LeoMaden/IDP-Robot-CAD/Robot-final-assembly.SLDASM

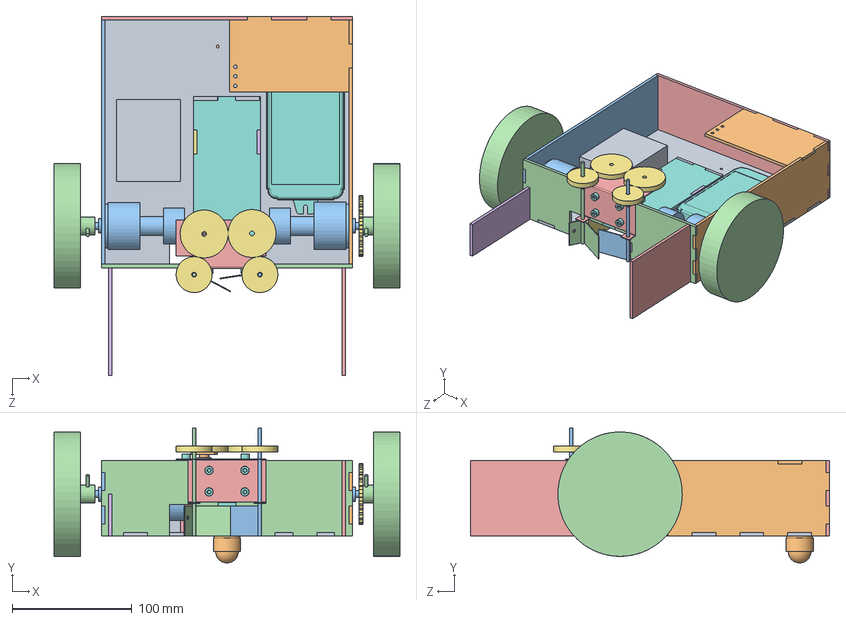
[picture p1: CAD file, 2020-11-09]
Robot-final-assembly.SLDASM
289.0 x 112.6 x 300.0 mm
Body-bottom
Body-left
Body-right
Body-front
Body-rear
Tunnel-left
Tunnel-right
Tunnel-top
Tunnel-rear
Name-plaque
Door-left
Door-right
Door-bracket
Servo
Gears x 4
socket head cap screw_iso x 8
hex thin nut chamfered gradeab_iso x 7
Servo-spline-piece
Large-motor x 2
Wheel x 2
Tall-ultrasound-piece
Short-ultrasound-piece
Toothed-wheel
Battery-box
Arduino-motor-shield
Caster Ball
