LeoMaden/IDP-Robot-CAD/Door-assembly.SLDASM

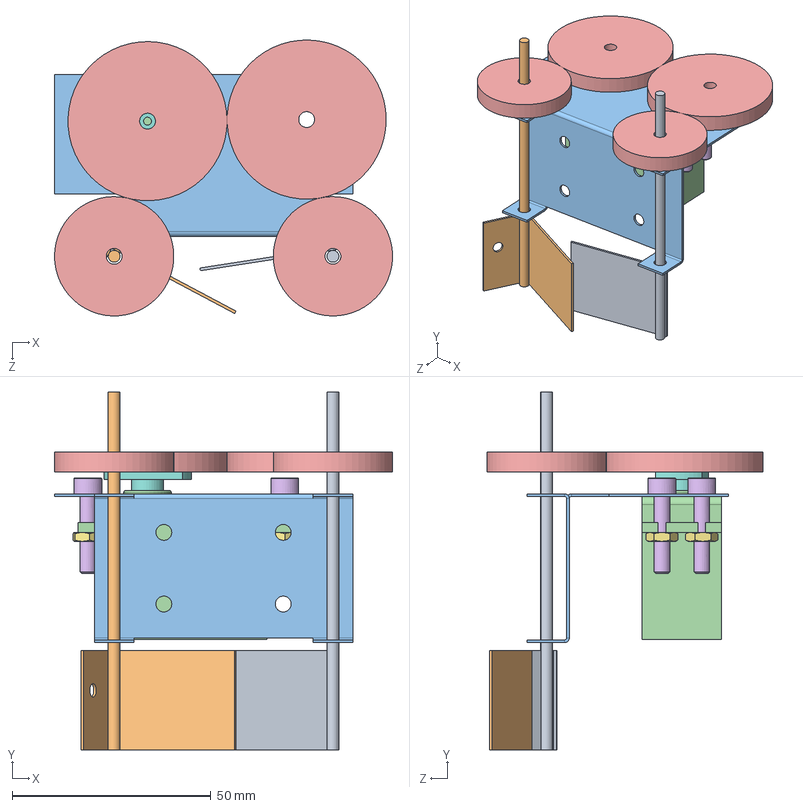
[picture p2: CAD file, 2020-11-09]
Door-assembly.SLDASM
85.0 x 90.0 x 69.4 mm
Door-left
Door-right
Door-bracket
Servo
Gears x 4
socket head cap screw_iso x 4
hex thin nut chamfered gradeab_iso x 3
Servo-spline-piece
