LeoMaden/IDP-Robot-CAD/Robot-assembly.SLDASM

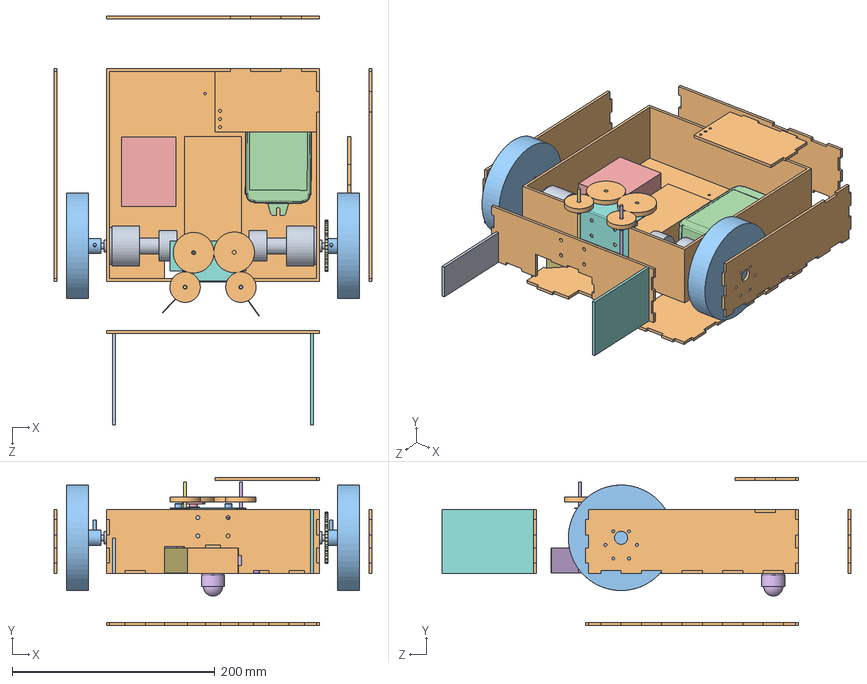
[picture p3: CAD file, 2020-11-08]
Robot-assembly.SLDASM
313.0 x 146.0 x 403.0 mm
Large-motor x 2
Robot-body
Wheel x 2
Battery-box
Arduino-motor-shield
Door-left
Door-right
Door-bracket
Servo
Gears x 4
socket head cap screw_iso x 4
hex thin nut chamfered gradeab_iso x 3
Servo-spline-piece
Caster Ball
Toothed-wheel
Tall-ultrasound-piece
Short-ultrasound-piece
