LeoMaden/IDP-Robot-CAD/Documentation/dxf drawings/Robot DXF Files/Body-right.DXF

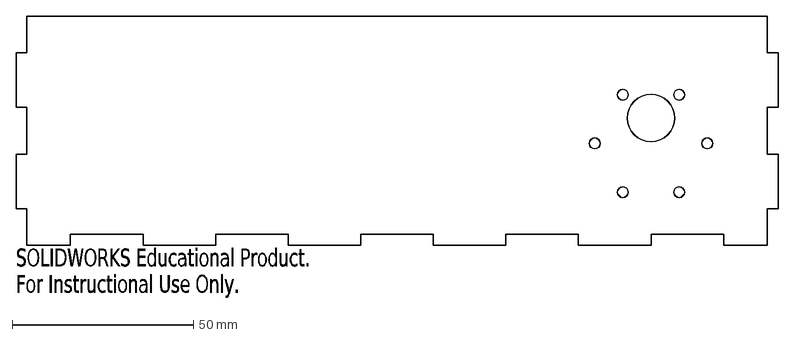
[picture p4: CAD file, 2020-11-09]
Documentation/dxf drawings/Robot DXF Files/Body-right.DXF
SOLIDWORKS Educational Product.
For Instructional Use Only.
