LeoMaden/IDP-Robot-CAD/Documentation/dxf drawings/Toothed-wheel.DXF

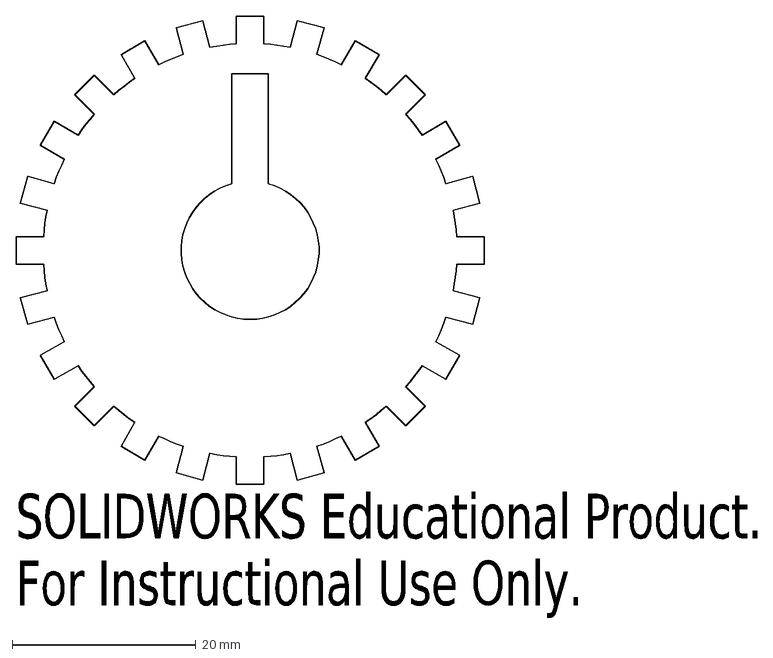
[picture p5: CAD file, 2020-11-09]
Documentation/dxf drawings/Toothed-wheel.DXF
SOLIDWORKS Educational Product.
For Instructional Use Only.
