LeoMaden/IDP-Robot-CAD/Name-plaque.sldprt

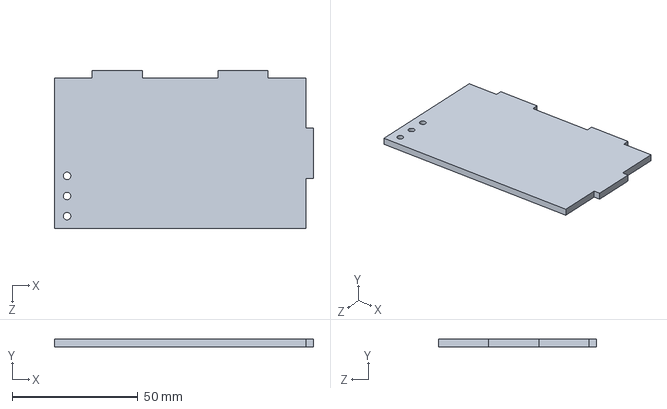
[picture p6: CAD file, 2020-11-09]
Name-plaque.sldprt
103.0 x 3.00 x 63.0 mm
