LeoMaden/IDP-Robot-CAD/Body-bottom.sldprt

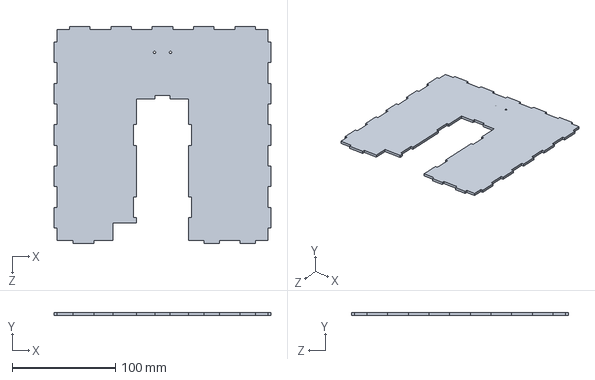
[picture p7: CAD file, 2020-11-09]
Body-bottom.sldprt
210.0 x 3.00 x 210.0 mm
