LeoMaden/IDP-Robot-CAD/Documentation/dxf drawings/Body-front.DXF

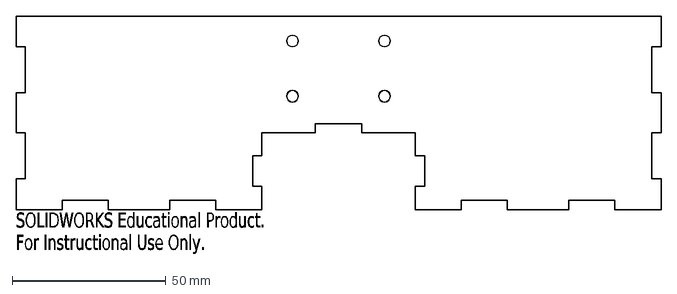
[picture p8: CAD file, 2020-11-09]
Documentation/dxf drawings/Body-front.DXF
SOLIDWORKS Educational Product.
For Instructional Use Only.
