LeoMaden/IDP-Robot-CAD/Documentation/dxf drawings/Robot DXF Files/New-Tunnel-right.DXF

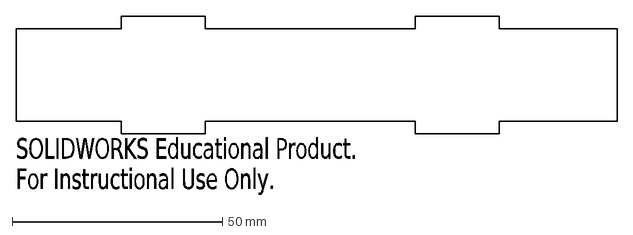
[picture p9: CAD file, 2020-11-09]
Documentation/dxf drawings/Robot DXF Files/New-Tunnel-right.DXF
SOLIDWORKS Educational Product.
For Instructional Use Only.
