LeoMaden/IDP-Robot-CAD/Documentation/dxf drawings/Body-bottom.DXF

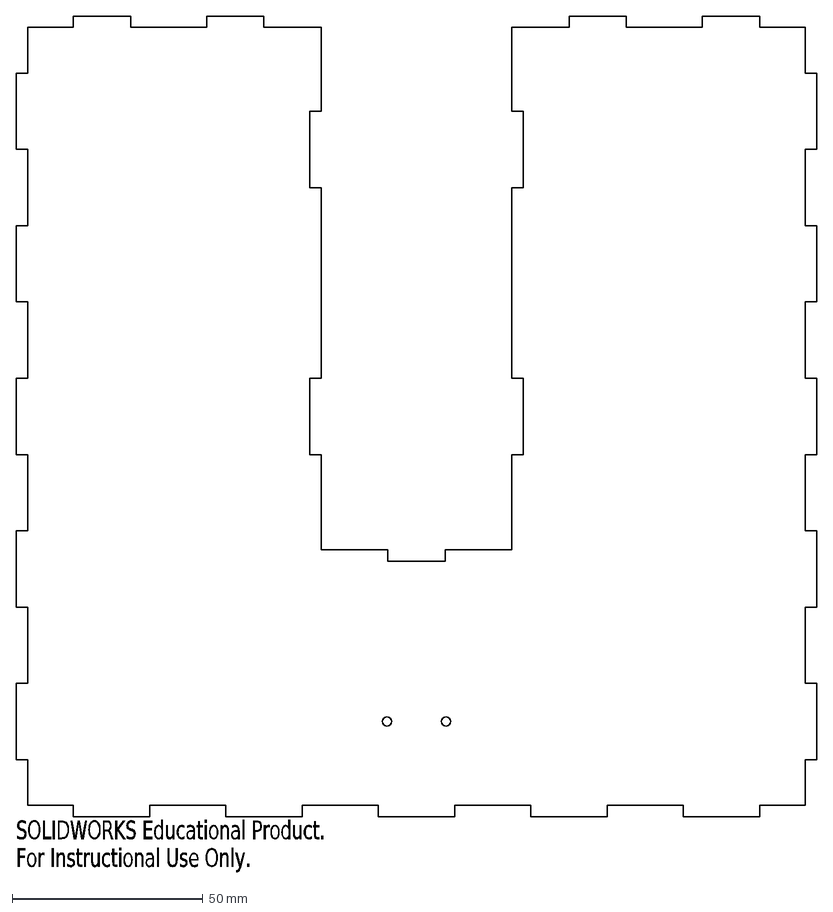
[picture p10: CAD file, 2020-11-09]
Documentation/dxf drawings/Body-bottom.DXF
SOLIDWORKS Educational Product.
For Instructional Use Only.
