LeoMaden/IDP-Robot-CAD/Documentation/dxf drawings/Robot DXF Files/Body-rear.DXF

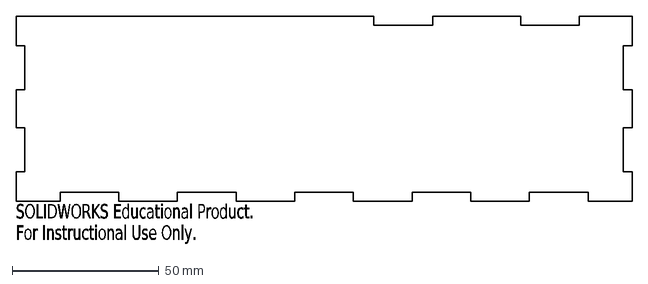
[picture p11: CAD file, 2020-11-09]
Documentation/dxf drawings/Robot DXF Files/Body-rear.DXF
SOLIDWORKS Educational Product.
For Instructional Use Only.
