LeoMaden/IDP-Robot-CAD/Tall-ultrasound-piece.SLDPRT

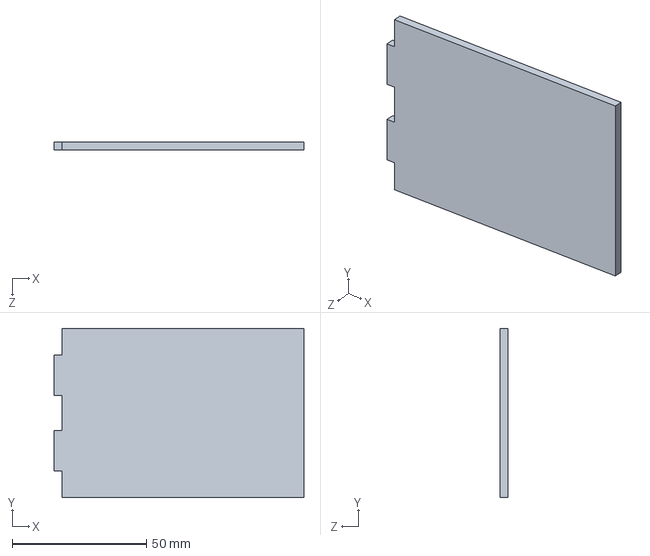
[picture p12: CAD file, 2020-11-09]
Tall-ultrasound-piece.SLDPRT
93.0 x 63.0 x 3.00 mm
