LeoMaden/IDP-Robot-CAD/Documentation/dxf drawings/Name-plaque.DXF

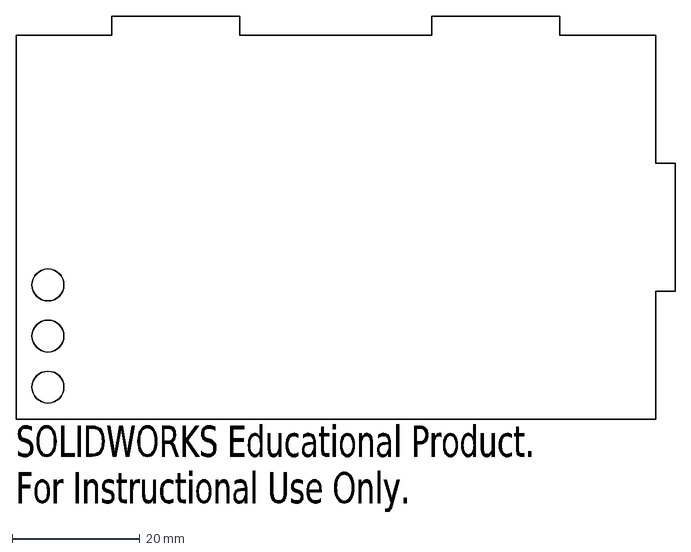
[picture p13: CAD file, 2020-11-09]
Documentation/dxf drawings/Name-plaque.DXF
SOLIDWORKS Educational Product.
For Instructional Use Only.
