LeoMaden/IDP-Robot-CAD/Documentation/dxf drawings/Robot DXF Files/New-Body-front.DXF

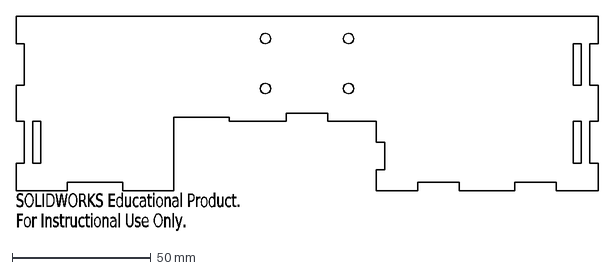
[picture p14: CAD file, 2020-11-09]
Documentation/dxf drawings/Robot DXF Files/New-Body-front.DXF
SOLIDWORKS Educational Product.
For Instructional Use Only.
