LeoMaden/IDP-Robot-CAD/Large-motor.SLDPRT

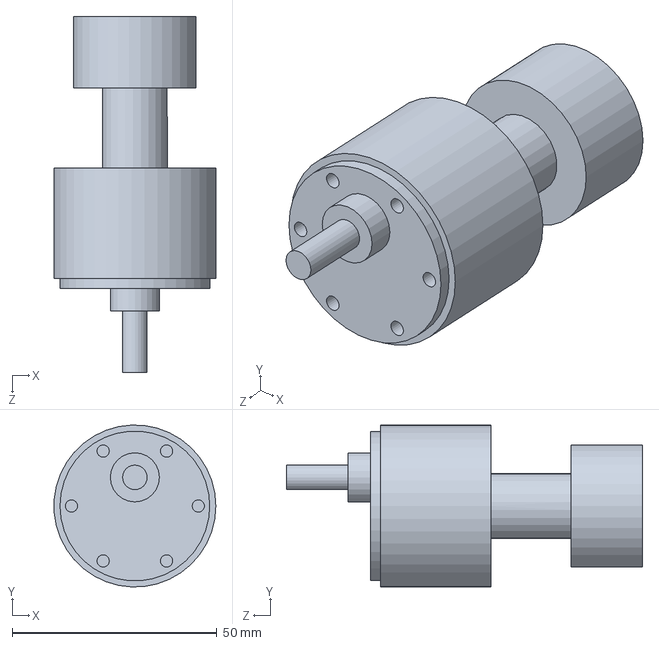
[picture p15: CAD file, 2020-11-09]
Large-motor.SLDPRT
39.5 x 39.6 x 87.0 mm
