LeoMaden/IDP-Robot-CAD/Documentation/dxf drawings/New-Body-bottom.DXF

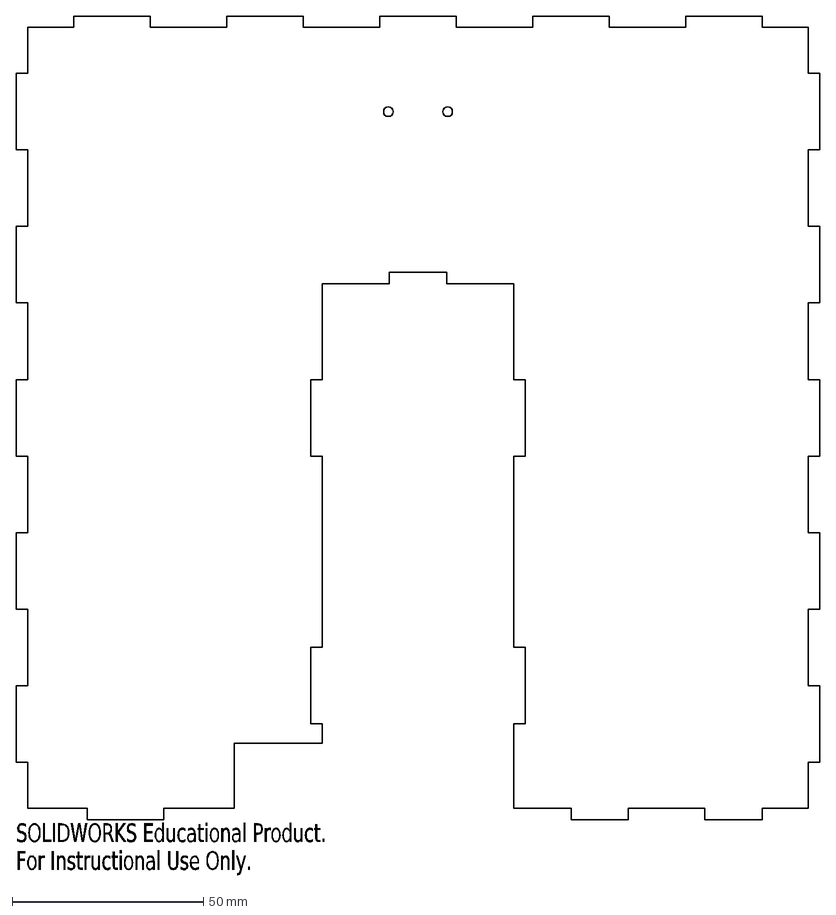
[picture p16: CAD file, 2020-11-03]
Documentation/dxf drawings/New-Body-bottom.DXF
SOLIDWORKS Educational Product.
For Instructional Use Only.
