LeoMaden/IDP-Robot-CAD/Documentation/dxf drawings/Robot DXF Files/Ultrasound-short.DXF

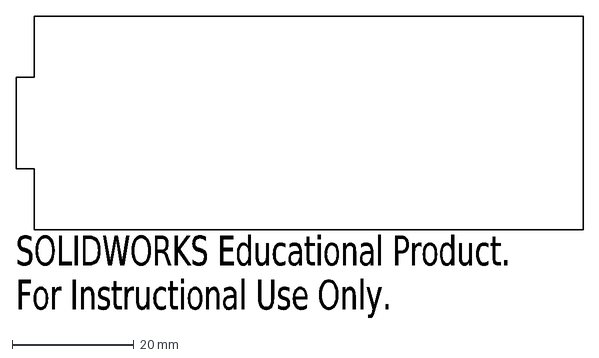
[picture p17: CAD file, 2020-11-09]
Documentation/dxf drawings/Robot DXF Files/Ultrasound-short.DXF
SOLIDWORKS Educational Product.
For Instructional Use Only.
