LeoMaden/IDP-Robot-CAD/Tunnel-left.sldprt

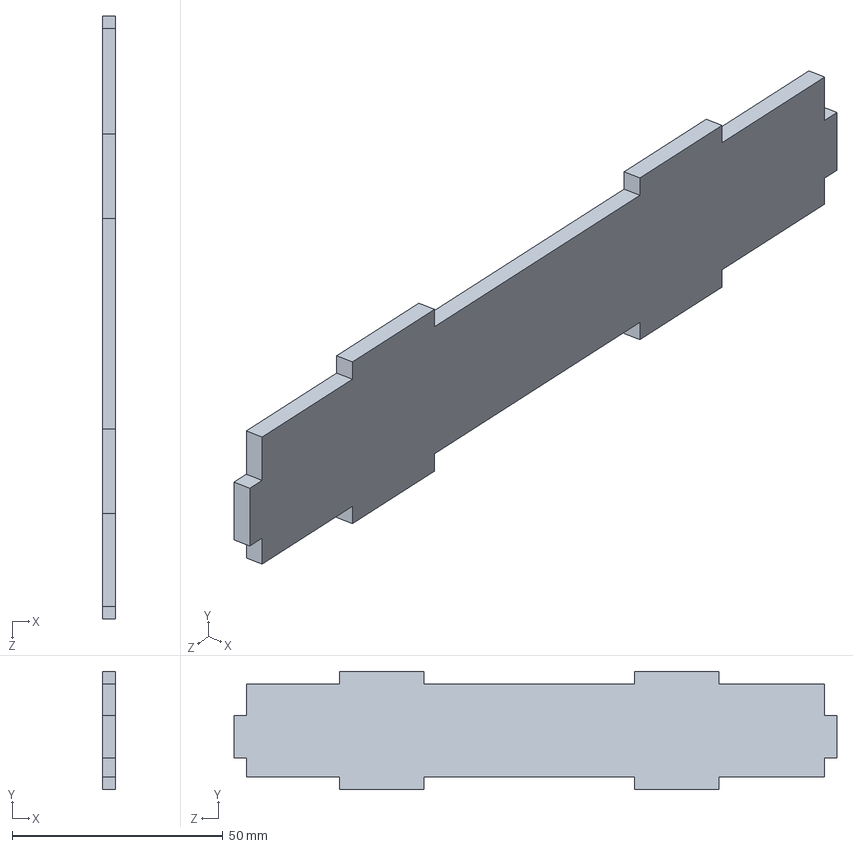
[picture p18: CAD file, 2020-11-09]
Tunnel-left.sldprt
3.00 x 28.0 x 143.0 mm
