LeoMaden/IDP-Robot-CAD/Documentation/dxf drawings/New-Name-plaque.DXF

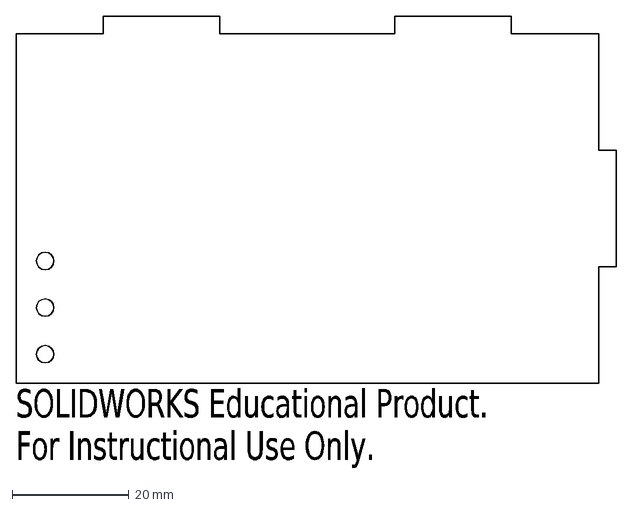
[picture p19: CAD file, 2020-11-03]
Documentation/dxf drawings/New-Name-plaque.DXF
SOLIDWORKS Educational Product.
For Instructional Use Only.
