LeoMaden/IDP-Robot-CAD/Documentation/dxf drawings/Robot DXF Files/Body-left.DXF

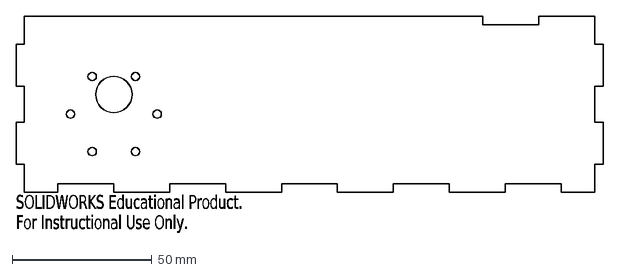
[picture p20: CAD file, 2020-11-09]
Documentation/dxf drawings/Robot DXF Files/Body-left.DXF
SOLIDWORKS Educational Product.
For Instructional Use Only.
