LeoMaden/IDP-Robot-CAD/Tunnel-right.sldprt

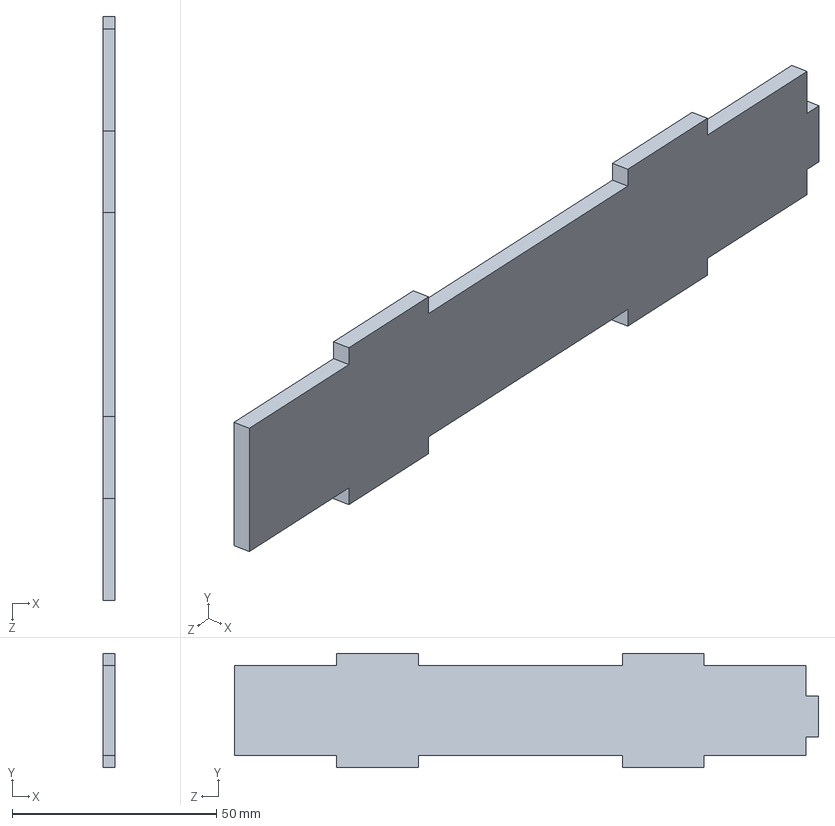
[picture p21: CAD file, 2020-11-09]
Tunnel-right.sldprt
3.00 x 28.0 x 143.0 mm
