LeoMaden/IDP-Robot-CAD/Arduino-motor-shield.SLDPRT

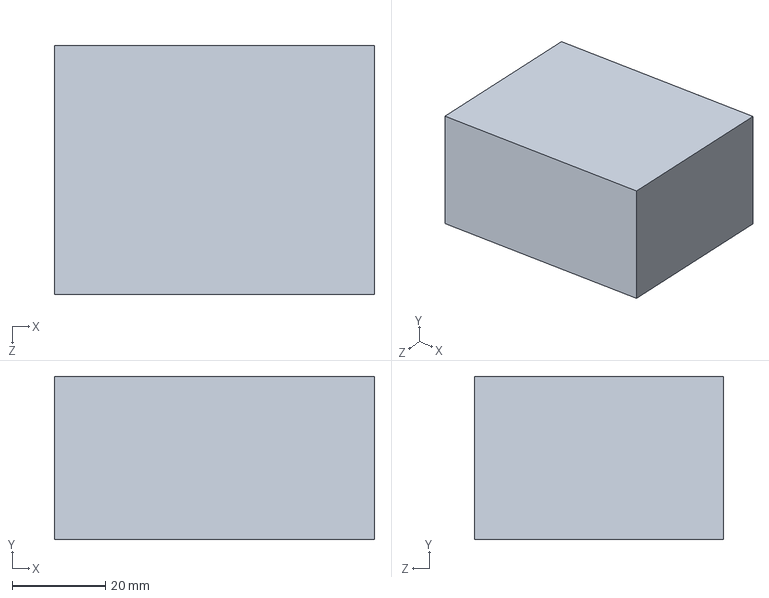
[picture p22: CAD file, 2020-11-09]
Arduino-motor-shield.SLDPRT
68.6 x 35.0 x 53.4 mm
