LeoMaden/IDP-Robot-CAD/Documentation/dxf drawings/New-Tunnel-right.DXF

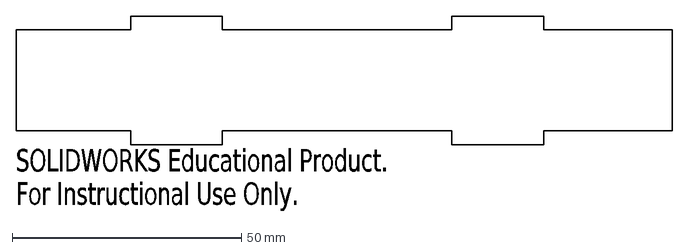
[picture p23: CAD file, 2020-11-03]
Documentation/dxf drawings/New-Tunnel-right.DXF
SOLIDWORKS Educational Product.
For Instructional Use Only.
