LeoMaden/IDP-Robot-CAD/Documentation/dxf drawings/Robot DXF Files/New-Toothed-wheel.DXF

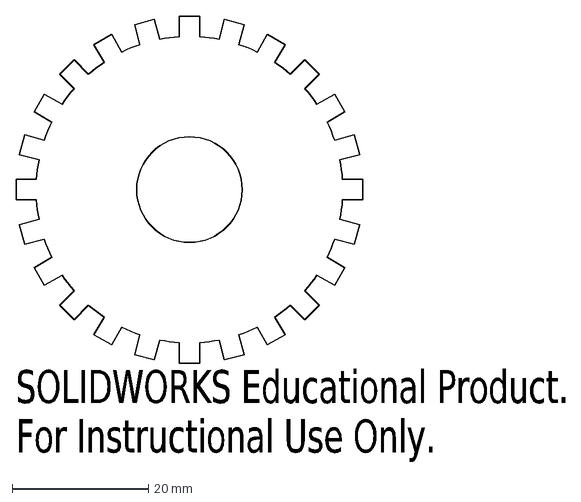
[picture p24: CAD file, 2020-11-09]
Documentation/dxf drawings/Robot DXF Files/New-Toothed-wheel.DXF
SOLIDWORKS Educational Product.
For Instructional Use Only.
