LeoMaden/IDP-Robot-CAD/Documentation/dxf drawings/Robot DXF Files/New-Name-plaque.DXF

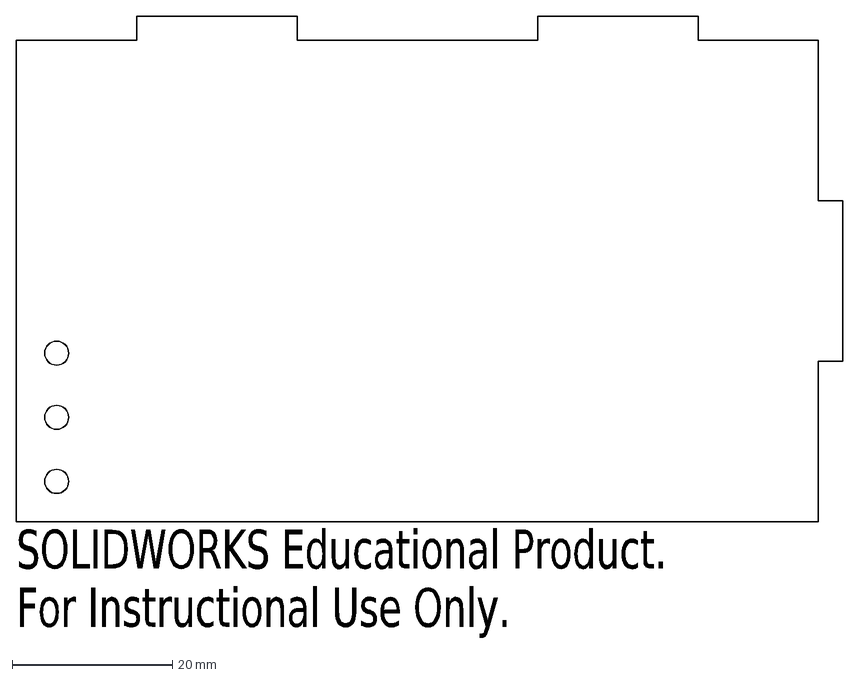
[picture p25: CAD file, 2020-11-09]
Documentation/dxf drawings/Robot DXF Files/New-Name-plaque.DXF
SOLIDWORKS Educational Product.
For Instructional Use Only.
