LeoMaden/IDP-Robot-CAD/Documentation/dxf drawings/Ultrasound-short.DXF

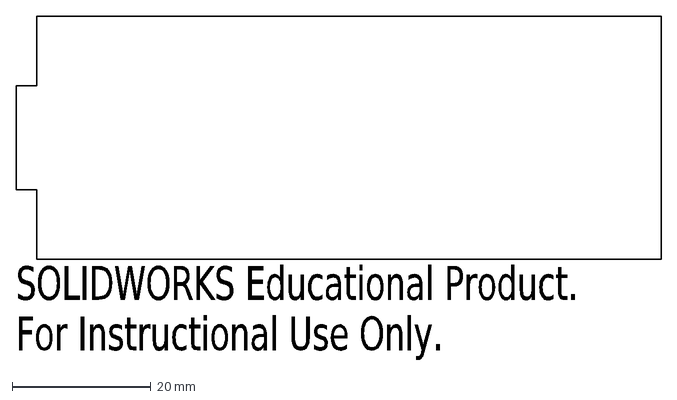
[picture p26: CAD file, 2020-11-03]
Documentation/dxf drawings/Ultrasound-short.DXF
SOLIDWORKS Educational Product.
For Instructional Use Only.
