LeoMaden/IDP-Robot-CAD/Door-bracket.SLDPRT

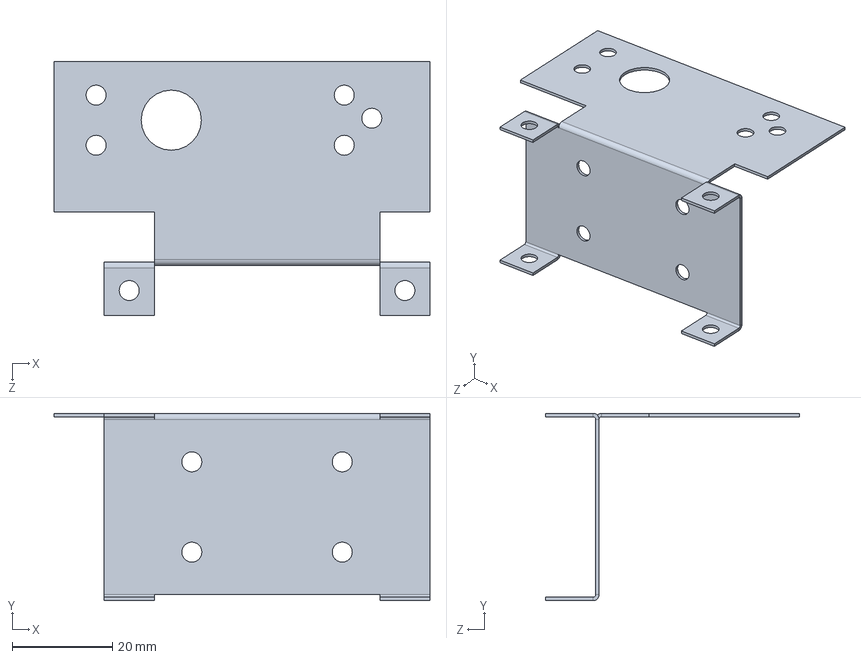
[picture p27: CAD file, 2020-11-09]
Door-bracket.SLDPRT
75.0 x 37.4 x 50.7 mm
