LeoMaden/IDP-Robot-CAD/Documentation/dxf drawings/New-Toothed-wheel.DXF

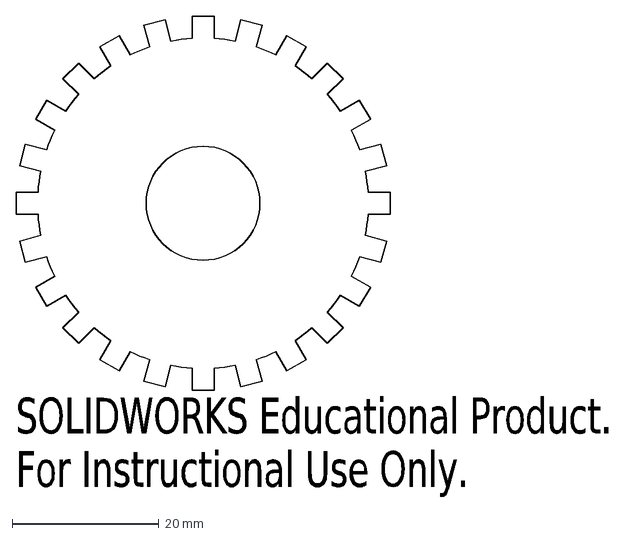
[picture p28: CAD file, 2020-11-03]
Documentation/dxf drawings/New-Toothed-wheel.DXF
SOLIDWORKS Educational Product.
For Instructional Use Only.
