LeoMaden/IDP-Robot-CAD/Documentation/dxf drawings/Robot DXF Files/Ultrasound-tall.DXF

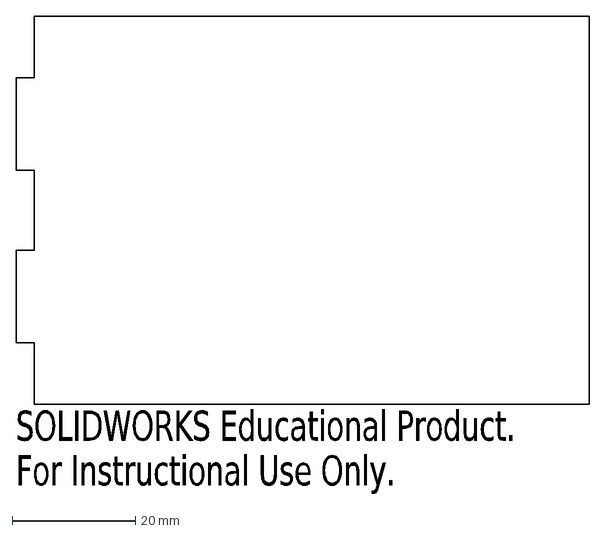
[picture p29: CAD file, 2020-11-09]
Documentation/dxf drawings/Robot DXF Files/Ultrasound-tall.DXF
SOLIDWORKS Educational Product.
For Instructional Use Only.
