LeoMaden/IDP-Robot-CAD/Servo.SLDPRT

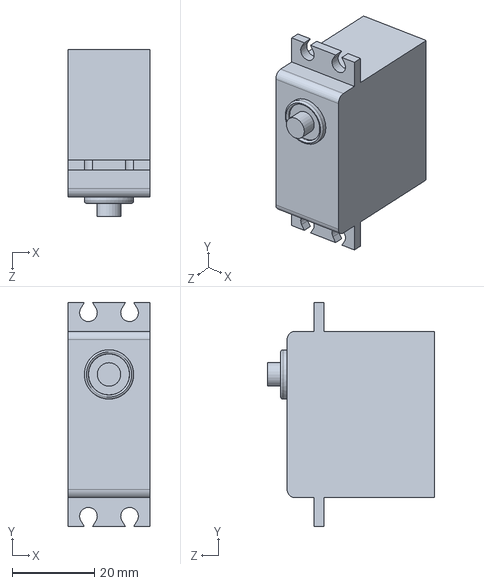
[picture p30: CAD file, 2020-11-09]
Servo.SLDPRT
20.0 x 54.5 x 40.6 mm
