LeoMaden/IDP-Robot-CAD/Documentation/dxf drawings/New-Body-front.DXF

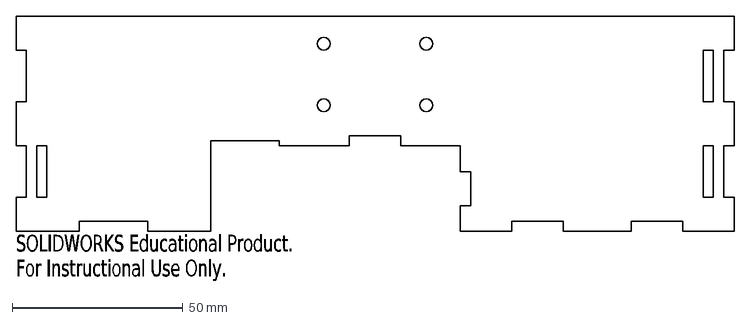
[picture p31: CAD file, 2020-11-03]
Documentation/dxf drawings/New-Body-front.DXF
SOLIDWORKS Educational Product.
For Instructional Use Only.
