LeoMaden/IDP-Robot-CAD/Documentation/dxf drawings/Robot DXF Files/New-Body-bottom.DXF

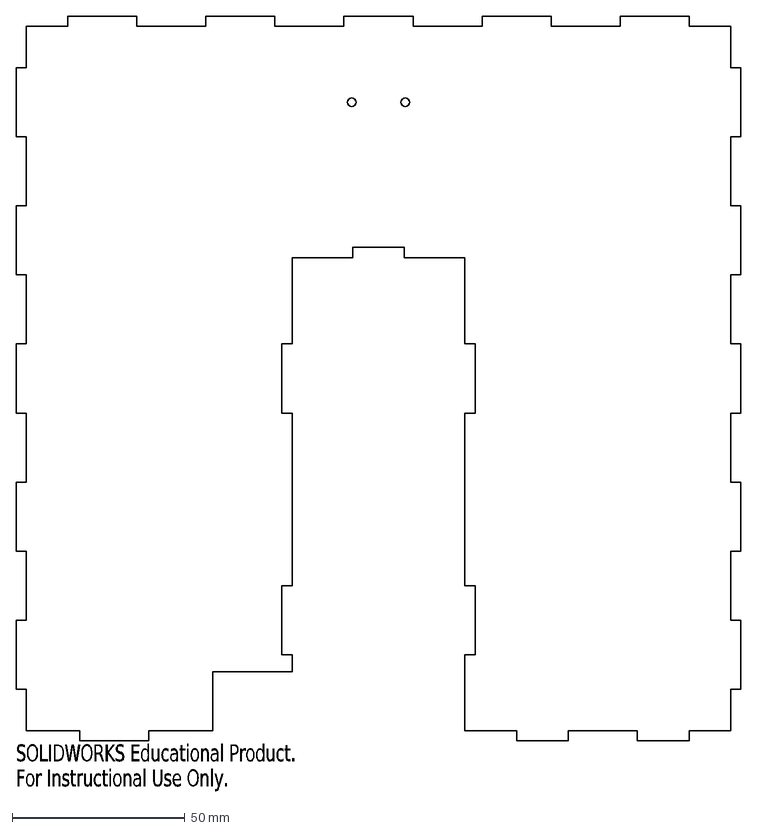
[picture p32: CAD file, 2020-11-09]
Documentation/dxf drawings/Robot DXF Files/New-Body-bottom.DXF
SOLIDWORKS Educational Product.
For Instructional Use Only.
