LeoMaden/IDP-Robot-CAD/Robot-body.sldprt

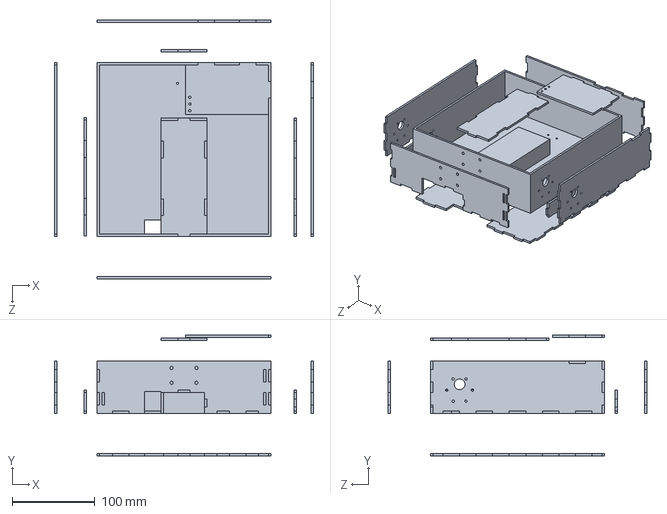
[picture p33: CAD file, 2020-11-09]
Robot-body.sldprt
313.0 x 146.0 x 313.0 mm
