LeoMaden/IDP-Robot-CAD/Documentation/dxf drawings/Robot DXF Files/Tunnel-top.DXF

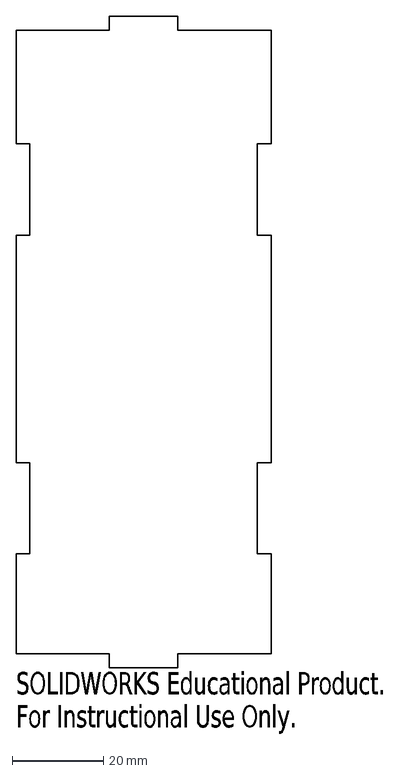
[picture p34: CAD file, 2020-10-27]
Documentation/dxf drawings/Robot DXF Files/Tunnel-top.DXF
SOLIDWORKS Educational Product.
For Instructional Use Only.
