LeoMaden/IDP-Robot-CAD/Documentation/dxf drawings/Ultrasound-tall.DXF

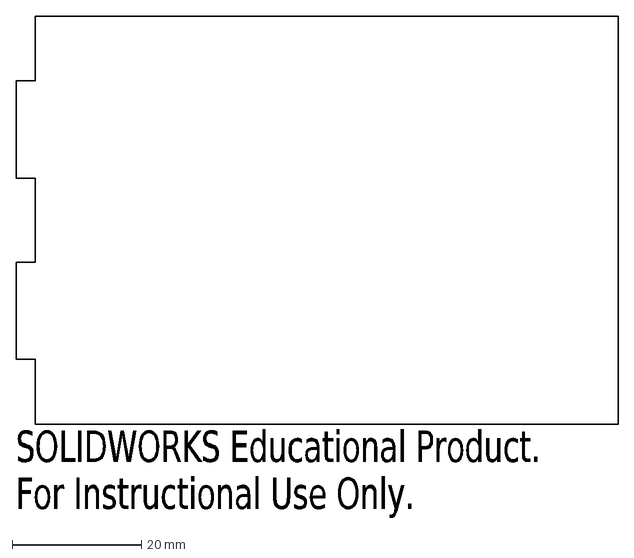
[picture p35: CAD file, 2020-11-03]
Documentation/dxf drawings/Ultrasound-tall.DXF
SOLIDWORKS Educational Product.
For Instructional Use Only.
