LeoMaden/IDP-Robot-CAD/Door-left.SLDPRT

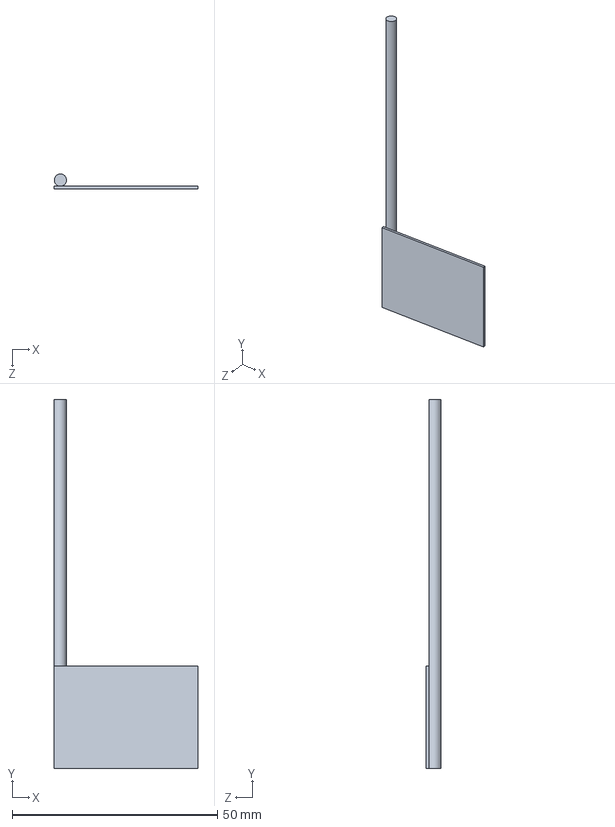
[picture p36: CAD file, 2020-11-09]
Door-left.SLDPRT
35.0 x 90.0 x 3.70 mm
