LeoMaden/IDP-Robot-CAD/Body-right.sldprt

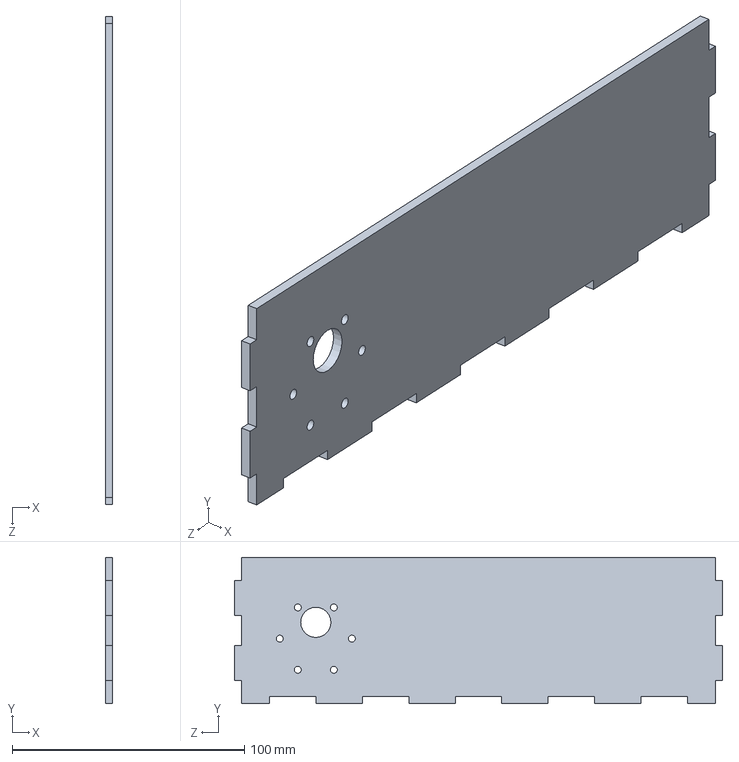
[picture p37: CAD file, 2020-11-09]
Body-right.sldprt
3.00 x 63.0 x 210.0 mm
