LeoMaden/IDP-Robot-CAD/Documentation/dxf drawings/Robot DXF Files/Tunnel-left.DXF

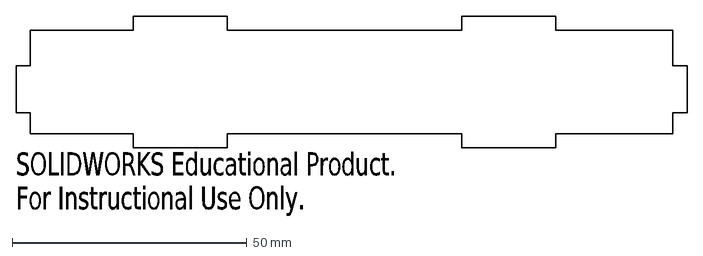
[picture p38: CAD file, 2020-10-27]
Documentation/dxf drawings/Robot DXF Files/Tunnel-left.DXF
SOLIDWORKS Educational Product.
For Instructional Use Only.
