LeoMaden/IDP-Robot-CAD/Documentation/dxf drawings/Tunnel-right.DXF

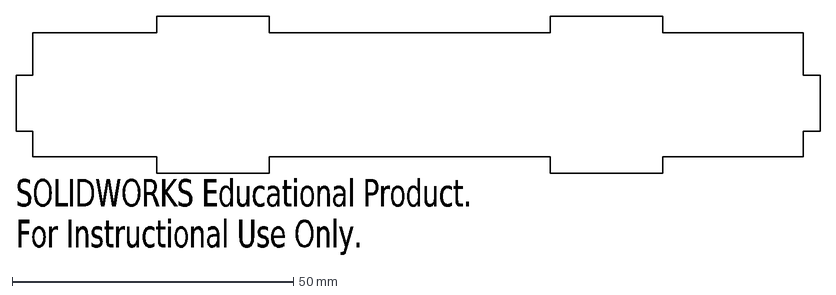
[picture p39: CAD file, 2020-10-27]
Documentation/dxf drawings/Tunnel-right.DXF
SOLIDWORKS Educational Product.
For Instructional Use Only.
