LeoMaden/IDP-Robot-CAD/Documentation/dxf drawings/Body-right.DXF

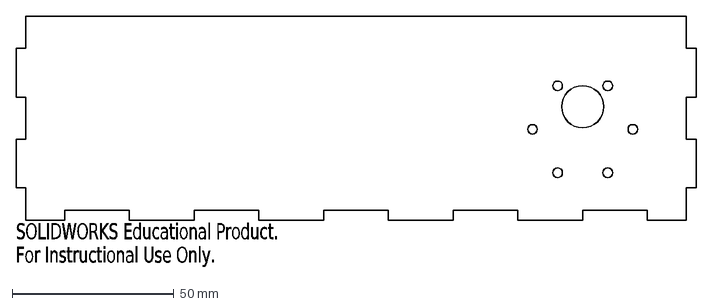
[picture p40: CAD file, 2020-10-27]
Documentation/dxf drawings/Body-right.DXF
SOLIDWORKS Educational Product.
For Instructional Use Only.
