LeoMaden/IDP-Robot-CAD/Documentation/dxf drawings/Robot DXF Files/Tunnel-back.DXF

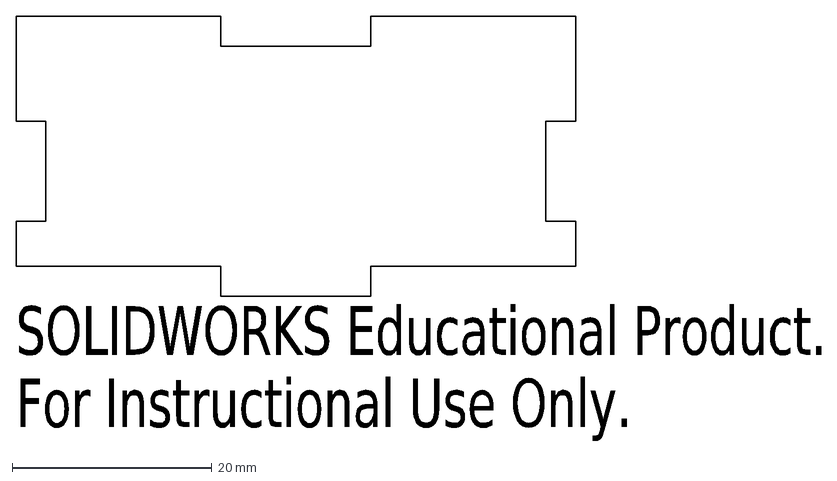
[picture p41: CAD file, 2020-10-27]
Documentation/dxf drawings/Robot DXF Files/Tunnel-back.DXF
SOLIDWORKS Educational Product.
For Instructional Use Only.
