LeoMaden/IDP-Robot-CAD/Documentation/dxf drawings/Body-left.DXF

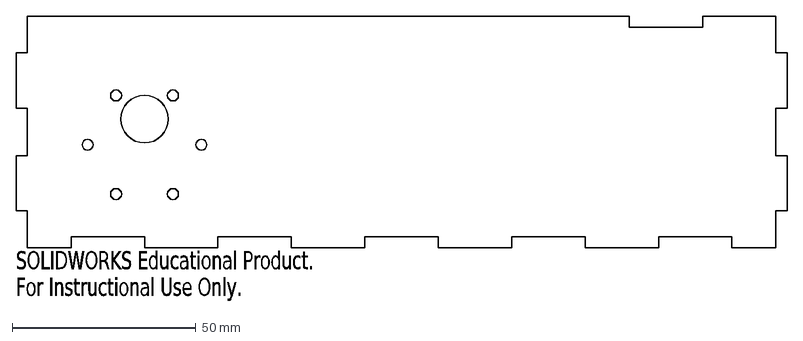
[picture p42: CAD file, 2020-10-27]
Documentation/dxf drawings/Body-left.DXF
SOLIDWORKS Educational Product.
For Instructional Use Only.
