LeoMaden/IDP-Robot-CAD/Documentation/dxf drawings/Body-rear.DXF

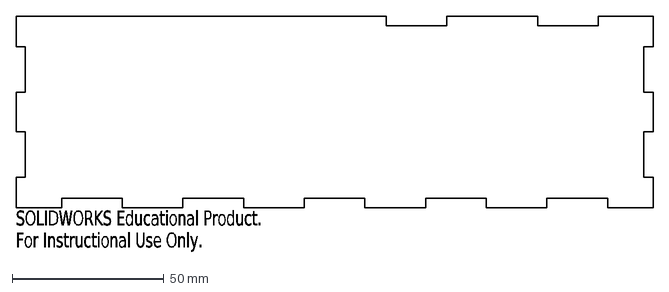
[picture p43: CAD file, 2020-10-27]
Documentation/dxf drawings/Body-rear.DXF
SOLIDWORKS Educational Product.
For Instructional Use Only.
