LeoMaden/IDP-Robot-CAD/Short-ultrasound-piece.SLDPRT

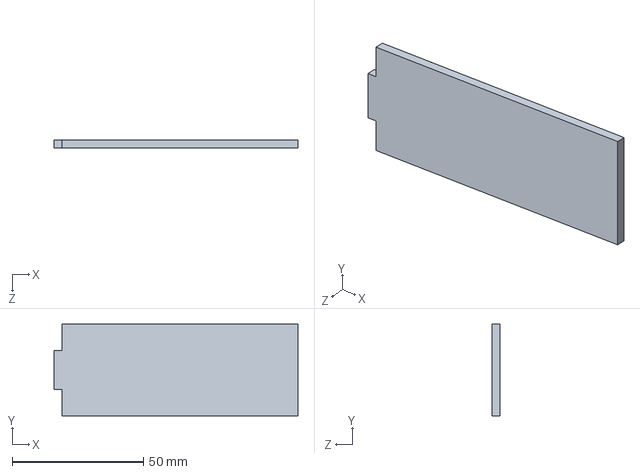
[picture p44: CAD file, 2020-11-09]
Short-ultrasound-piece.SLDPRT
93.0 x 35.0 x 3.00 mm
