LeoMaden/IDP-Robot-CAD/Gears.SLDPRT

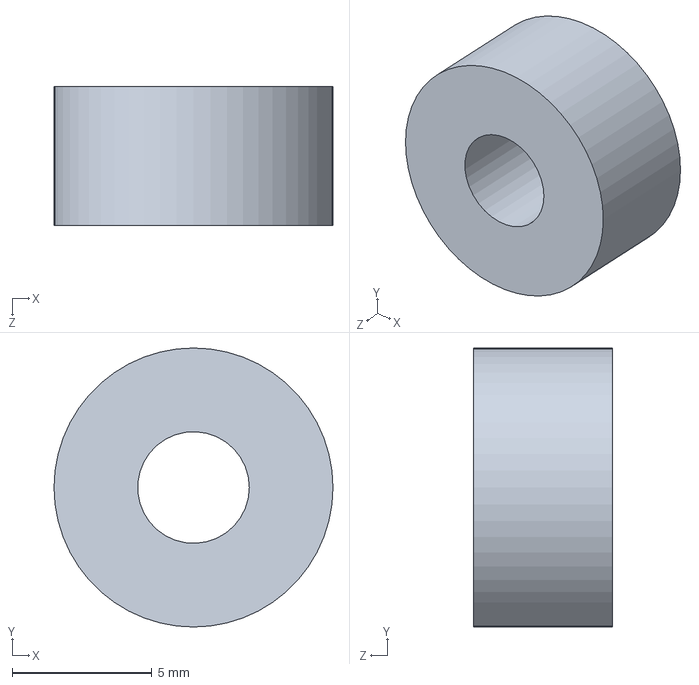
[picture p45: CAD file, 2020-11-09]
Gears.SLDPRT
10.0 x 10.0 x 5.00 mm
