LeoMaden/IDP-Robot-CAD/Wheel.SLDPRT

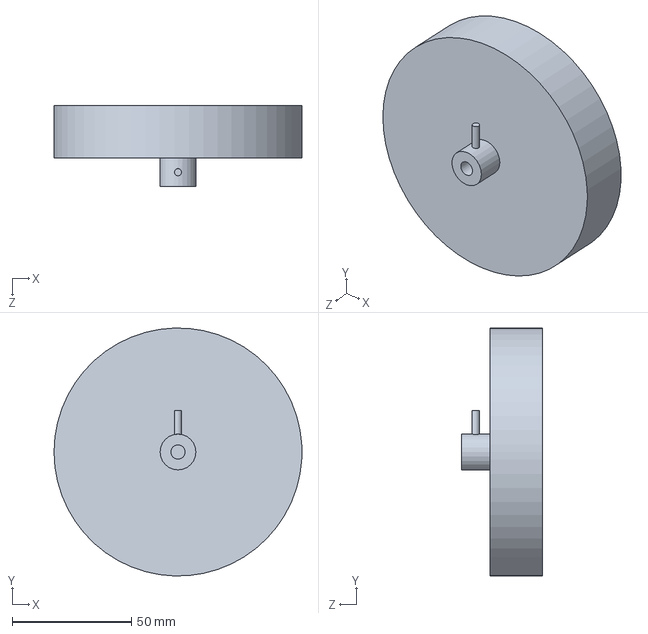
[picture p46: CAD file, 2020-11-09]
Wheel.SLDPRT
104.0 x 104.0 x 34.0 mm
