LeoMaden/IDP-Robot-CAD/Toothed-wheel.SLDPRT

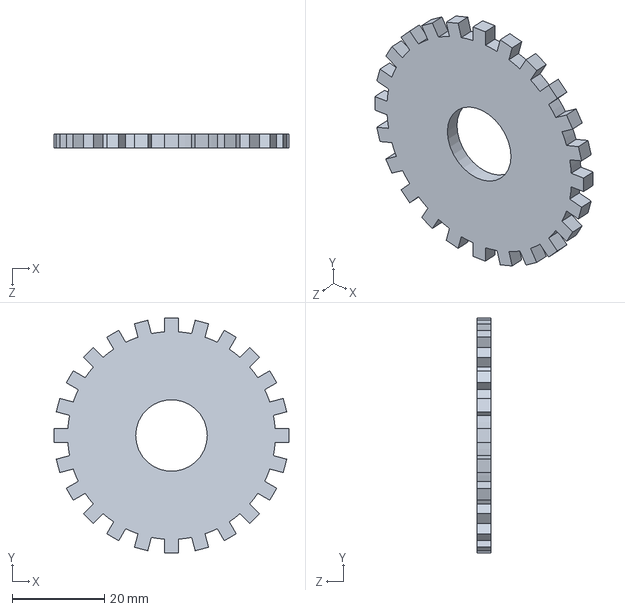
[picture p47: CAD file, 2020-11-09]
Toothed-wheel.SLDPRT
50.9 x 50.9 x 3.00 mm
