LeoMaden/IDP-Robot-CAD/Tunnel-rear.sldprt

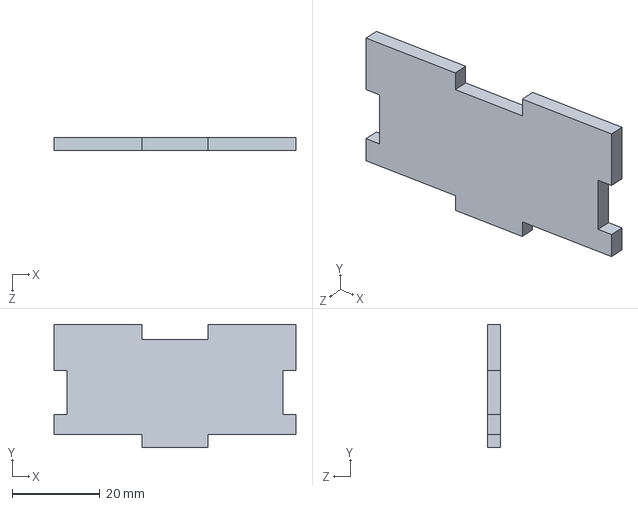
[picture p48: CAD file, 2020-11-09]
Tunnel-rear.sldprt
55.0 x 28.0 x 3.00 mm
