LeoMaden/IDP-Robot-CAD/Battery-box.SLDPRT

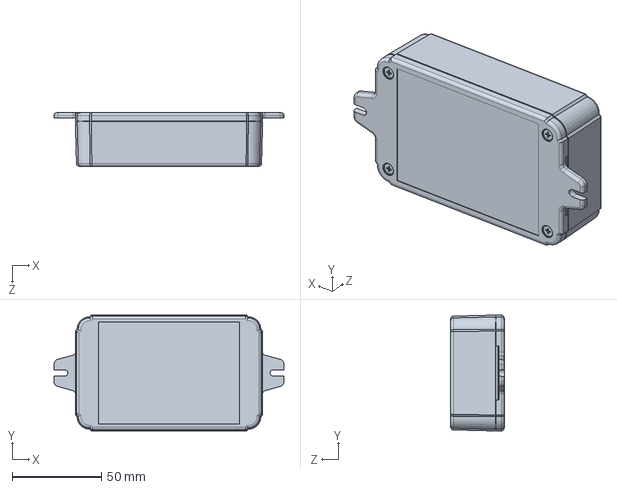
[picture p49: CAD file, 2020-11-09]
Battery-box.SLDPRT
128.9 x 65.0 x 30.0 mm
