LeoMaden/IDP-Robot-CAD/Tunnel-top.sldprt

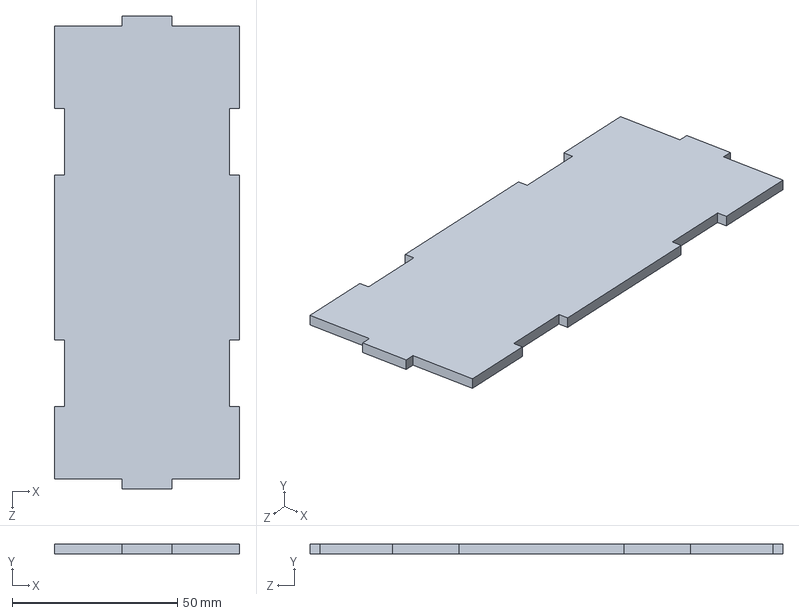
[picture p50: CAD file, 2020-11-09]
Tunnel-top.sldprt
56.0 x 3.00 x 143.0 mm
