LeoMaden/IDP-Robot-CAD/Door-right.SLDPRT

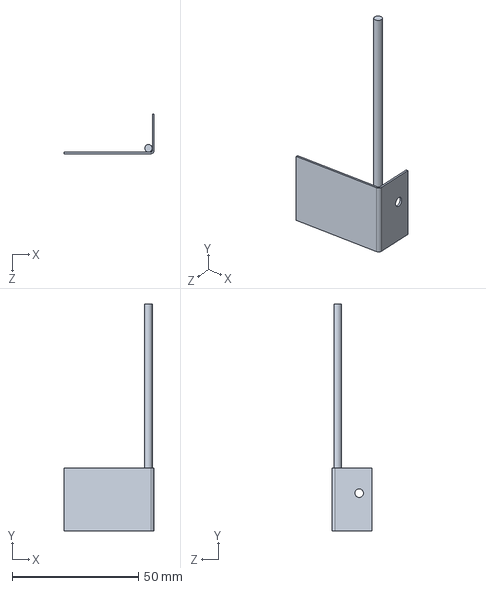
[picture p51: CAD file, 2020-11-09]
Door-right.SLDPRT
35.7 x 90.0 x 15.7 mm
