LeoMaden/IDP-Robot-CAD/Caster Ball.SLDPRT

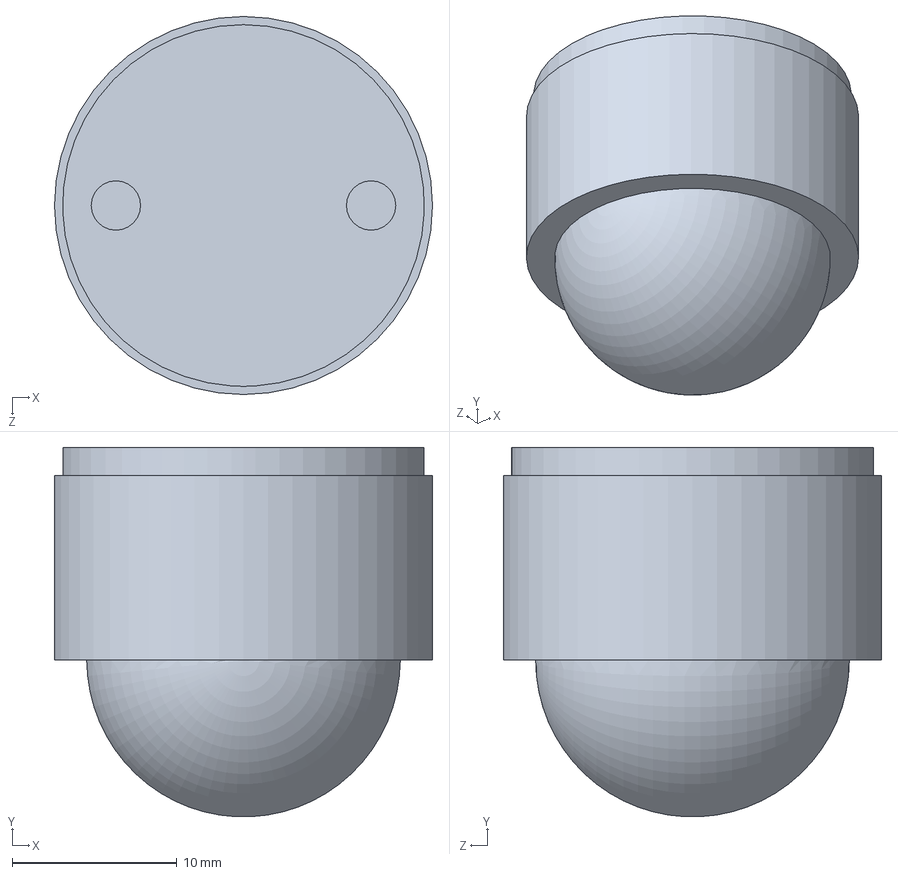
[picture p52: CAD file, 2020-11-09]
Caster Ball.SLDPRT
22.9 x 22.4 x 22.9 mm
