LeoMaden/IDP-Robot-CAD/Servo-spline-piece.SLDPRT

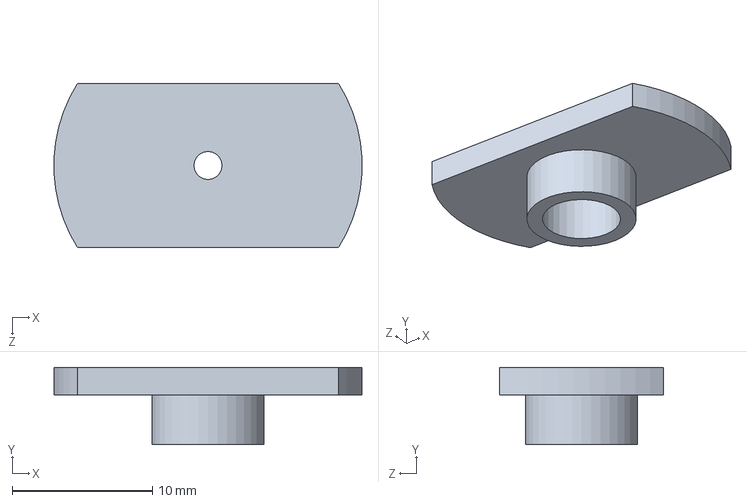
[picture p53: CAD file, 2020-11-09]
Servo-spline-piece.SLDPRT
22.0 x 5.50 x 11.7 mm
