LeoMaden/IDP-Robot-CAD/Body-front.sldprt

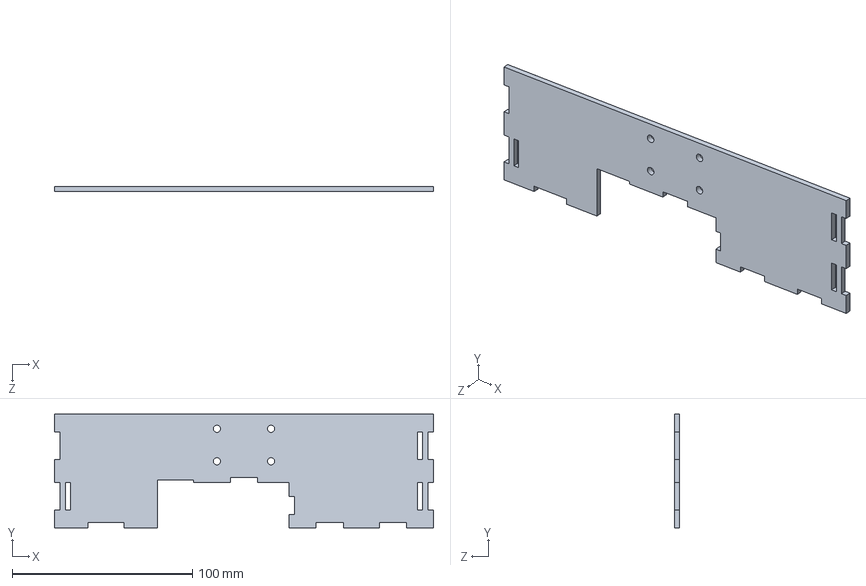
[picture p54: CAD file, 2020-11-09]
Body-front.sldprt
210.0 x 63.0 x 3.00 mm
