LeoMaden/IDP-Robot-CAD/(list of files, cad)

Other CAD files:
Body-rear.sldprt
Body-left.sldprt
Documentation/Body-front.SLDDRW
Documentation/Body-sides.SLDDRW
Documentation/Door-assembly.SLDDRW
Documentation/Door-bracket.SLDDRW
Documentation/Doors.SLDDRW
Documentation/Robot-final-assembly.SLDDRW
Documentation/Toothed-wheel.SLDDRW
Door-right - Copy.SLDPRT
