LeoMaden/IDP-Robot-CAD/Documentation/IDP Mechanical Documentation/Robot drawings and Manufacturing Notes.pdf

## Photo-interruptor

## Team name and

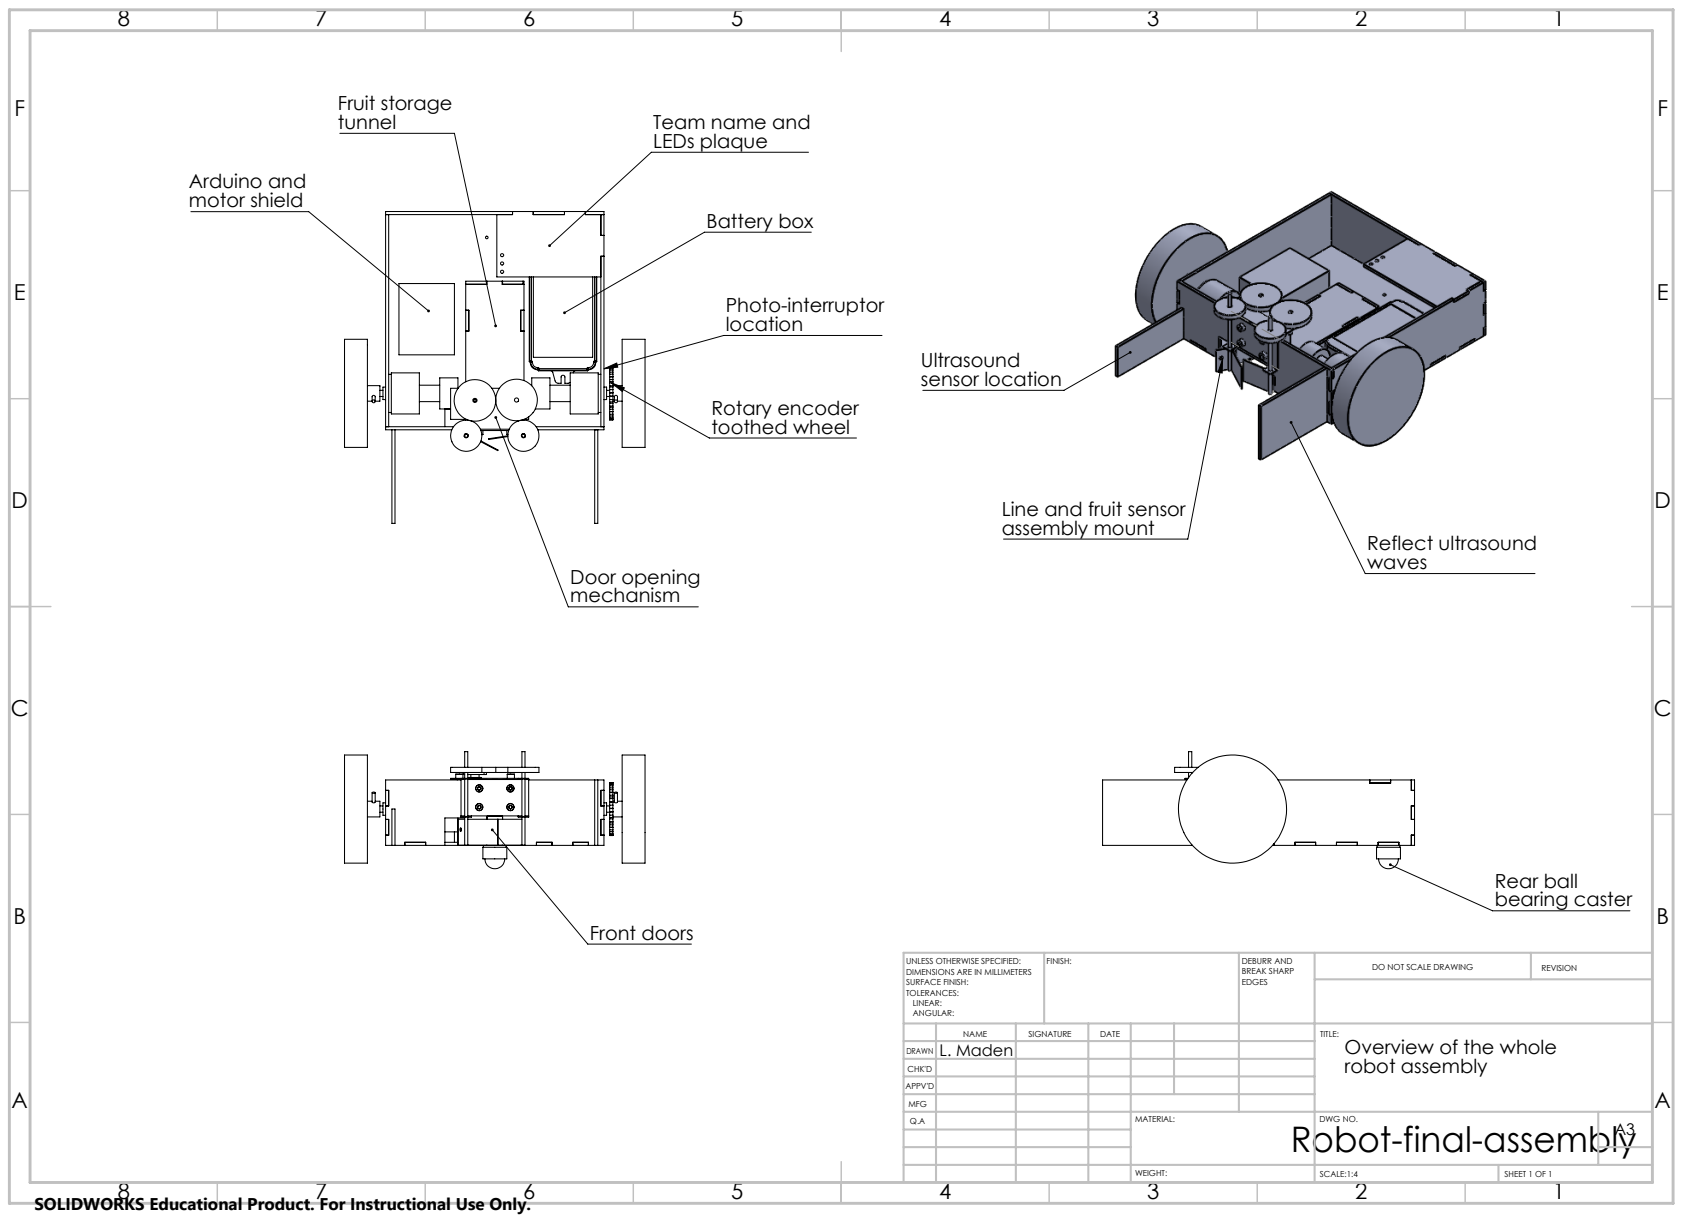
[picture p55: page 1]
Ultrasound sensor location; Reflect ultrasound waves; Front doors; Rotary encoder toothed wheel; location; LEDs plaque; Battery box; Fruit storage tunnel; Arduino and motor shield; Door opening mechanism; Rear ball bearing caster; FINISH:; DEBURR AND; BREAK SHARP EDGES; DO NOT SCALE DRAWING; REVISION; SCALE:1:4; SHEET 1 OF 1; WEIGHT:

Line and fruit sensor
assembly mount

UNLESS OTHERWISE SPECIFIED:
DIMENSIONS ARE IN MILLIMETERS
SURFACE FINISH:
TOLERANCES:
LINEAR:
ANGULAR:

NAME | SIGNATURE | DATE | | | | TITLE: Overview of the whole
L. Maden CHK'D | | | | | | robot assembly DRAWN

APPV'D
MFG
Q.A | | | | MATERIAL: Robot-final-assembly | DWG NO. | A3

SOLIDWORKS Educational Product. For Instructional Use Only.

## other gears fixed between bolt and

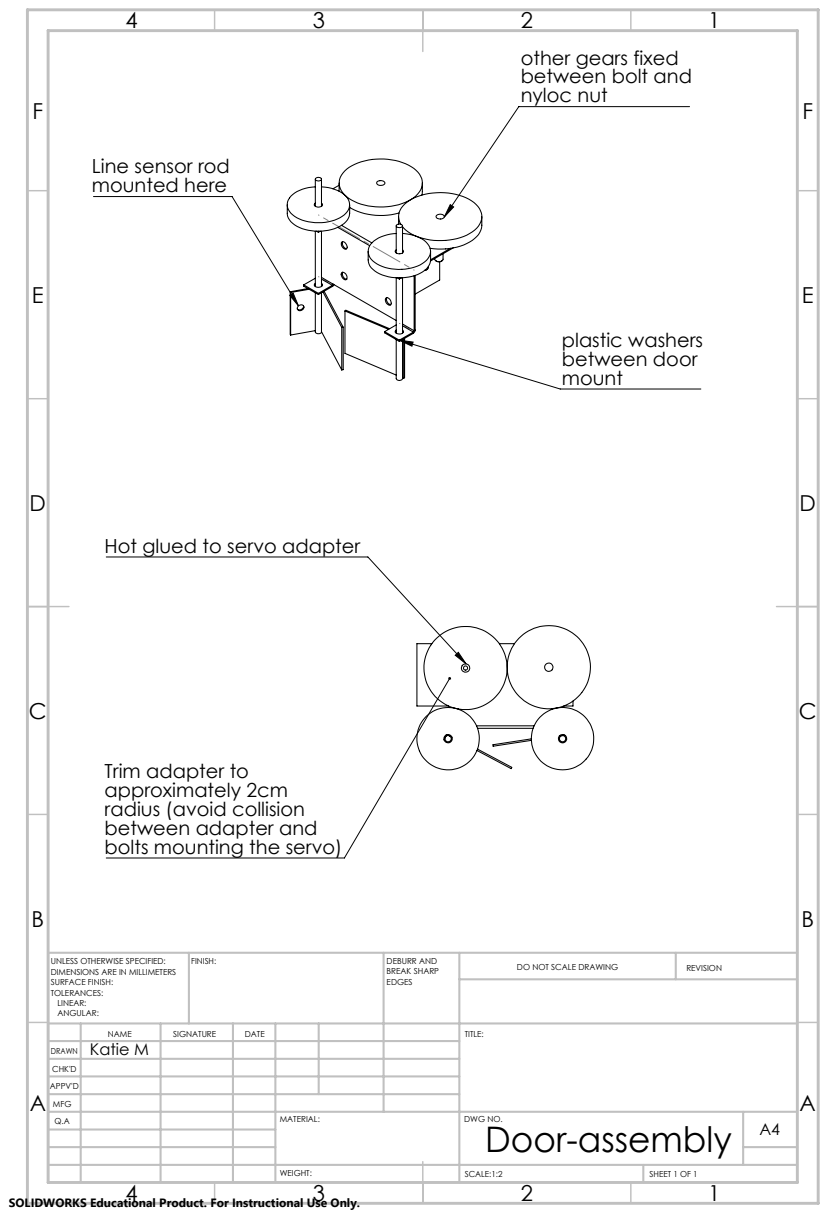
[picture p56: page 2]
nyloc nut; plastic washers between door mount; FINISH:; DEBURR AND; BREAK SHARP EDGES; DO NOT SCALE DRAWING; REVISION

Line sensor rod
mounted here

Hot glued to servo adapter

Trim adapter to
approximately 2cm
radius (avoid collision
between adapter and
bolts mounting the servo)

UNLESS OTHERWISE SPECIFIED:
DIMENSIONS ARE IN MILLIMETERS
SURFACE FINISH:
TOLERANCES:
LINEAR:
ANGULAR:

NAME | SIGNATURE | DATE | | | TITLE:
DRAWN | Katie M

CHK'D
APPV'D
MFG

Door-assembly

SCALE:1:2 | SHEET 1 OF 1

75.00

8.39

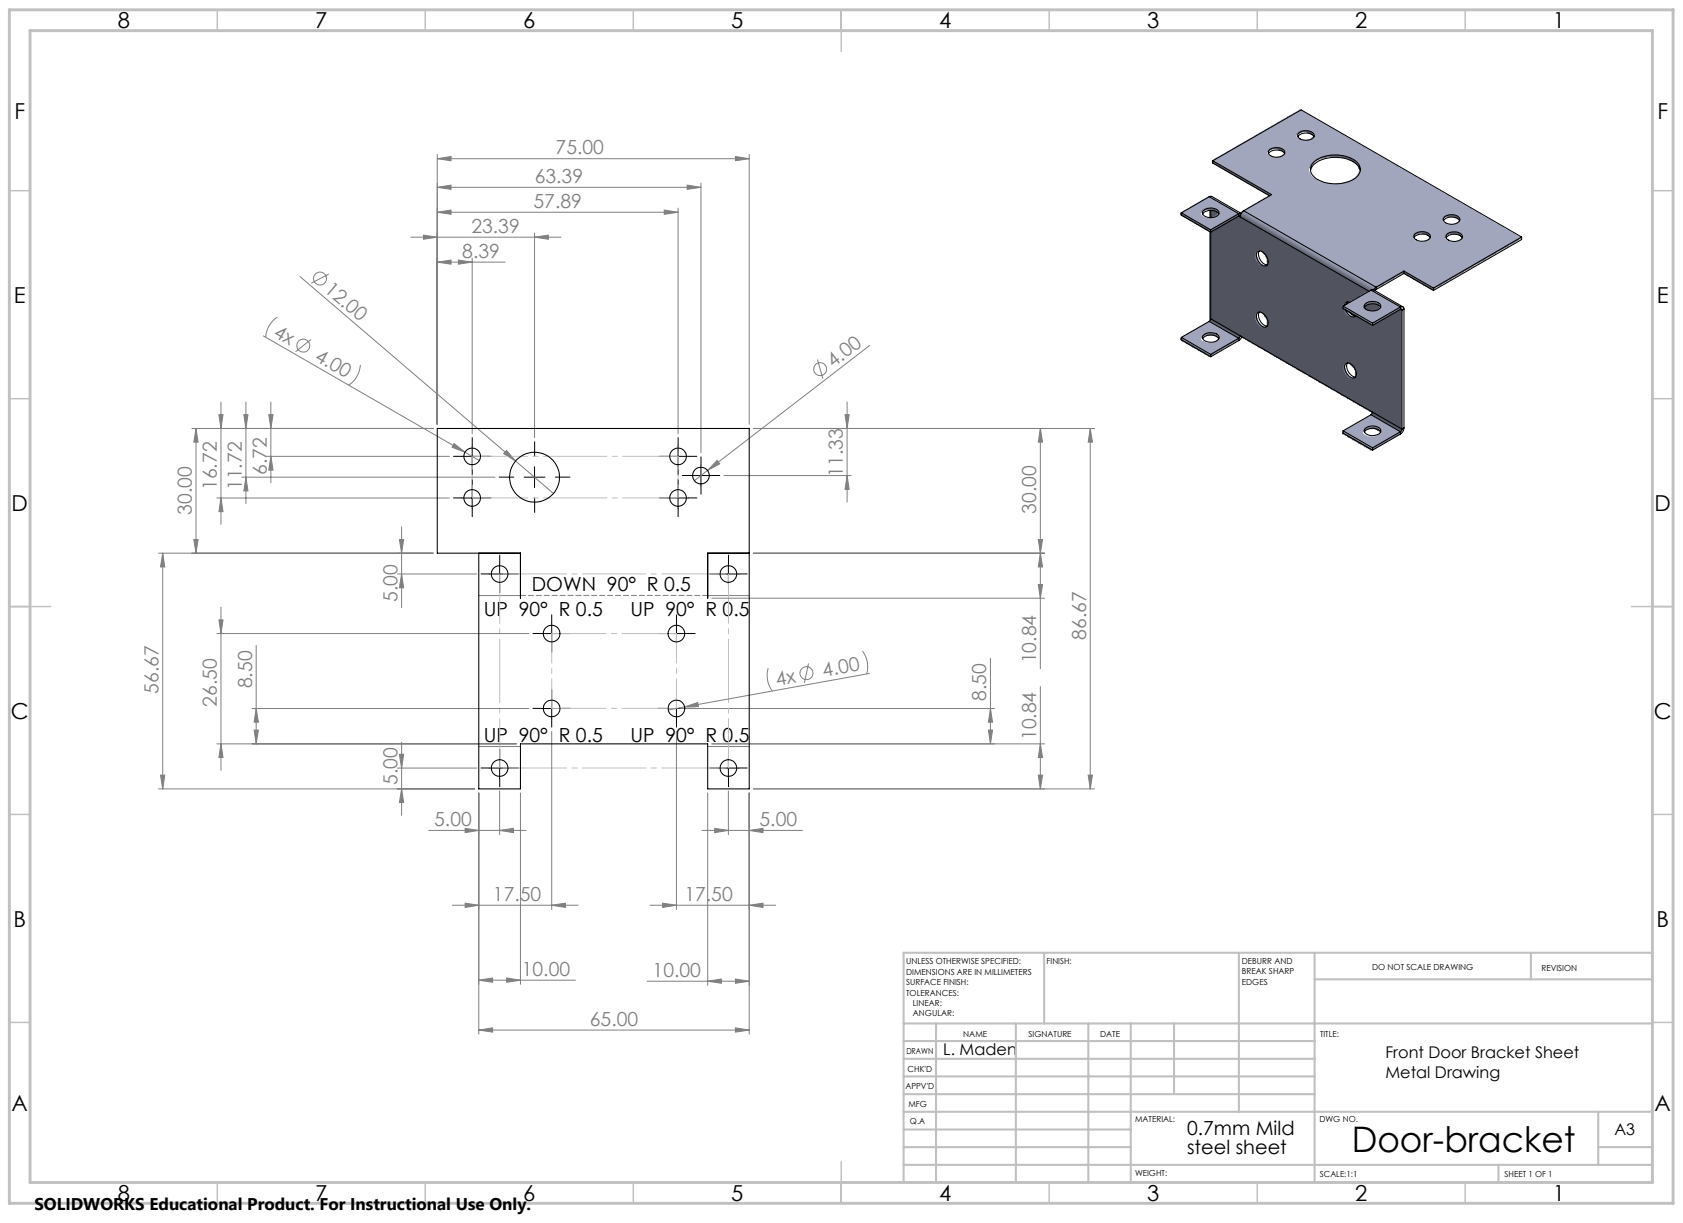
[picture p57: page 3]
DOWN 90° R 0.5; FINISH:; DEBURR AND; BREAK SHARP EDGES; DO NOT SCALE DRAWING; REVISION

UNLESS OTHERWISE SPECIFIED:
DIMENSIONS ARE IN MILLIMETERS
SURFACE FINISH:
TOLERANCES:
LINEAR:
ANGULAR:

NAME | SIGNATURE | DATE | | | | TITLE: Front Door Bracket Sheet Metal Drawing
DRAWN | L. Maden

CHK'D
APPV'D
MFG

0.7mm Mild steel sheet | Door-bracket

SCALE:1:1 | SHEET 1 OF 1

## 0.7 mm Mild steel sheet

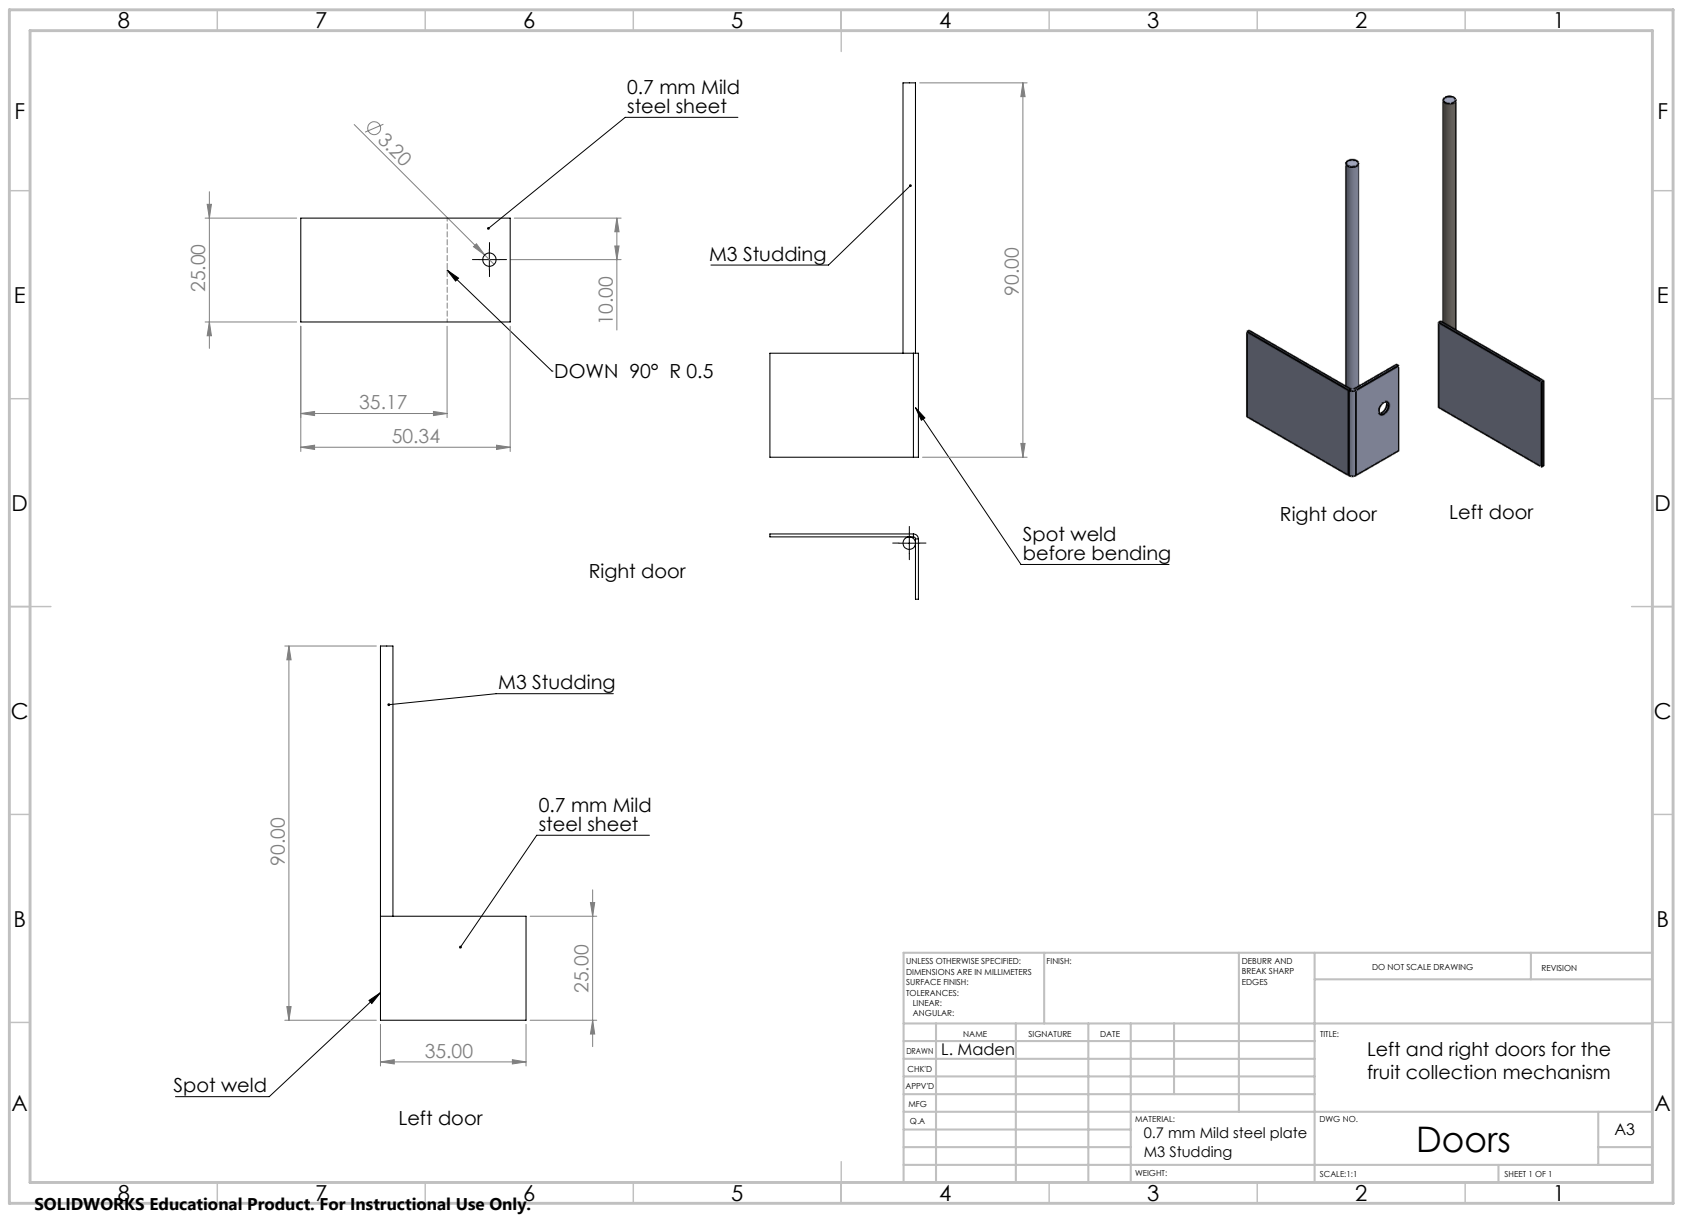
[picture p58: page 4]
Left door; DOWN 90° R 0.5; 0.7 mm Mild steel sheet; Spot weld; M3 Studding; Spot weld before bending; Right door; DRAWN; CHK'D; FINISH:; DEBURR AND; BREAK SHARP EDGES; NAME; SIGNATURE; DATE; DO NOT SCALE DRAWING; REVISION

UNLESS OTHERWISE SPECIFIED:
DIMENSIONS ARE IN MILLIMETERS
SURFACE FINISH:
TOLERANCES:
LINEAR:
ANGULAR:
L. Maden

TITLE:
Left and right doors for the
fruit collection mechanism

APPV'D
MFG

0.7 mm Mild steel plate M3 Studding | Doors

SCALE:1:1 | SHEET 1 OF 1

K. Milligan

### Manufacturing Notes

Front sensor mount

The line following sensors and LDR sensor are mounted on one of the doors at the front by a rod screwed through a tab on the door. The line following sensors slide along the rod which gives electrical teams ease to alter the sensors to improve the performance.

The LDR sensor is attached to the rod by a plate however with no obvious and easy mounting solution the actual sensor is held in place by hot glue. The position of the plate can be altered however the LDR is typically in a fixed position pointing directly at the fruit.

Ultrasound sensor mount

The ultrasound sensor although having holes in the structure to allow it to be mounted the small screw size wasn’t available therefore a sophisticated mount wasn’t feasible. The ultrasound sensor is mounted to the shortest tab via hot glue. The connecter for the circuit which is attached to the sensor is fairly bulky so sits on top of the tab ensuring that the sensor remains flat to the surface.

Door bracket

This part is fairly fiddly to manufacture by hand especially when cutting the tabs that hold the doors in place. However the section that holds together the gear plate and the door mount doesn’t need to be completely true to design as some material can be lost during the manufacturing as long as the plates are still connected. For example filling the cut line rather than using a saw will make manufacturing easier.
