LeoMaden/IDP-Robot-CAD/Documentation/pdf drawings/Door-assembly.PDF

plastic washers between door; FINISH:; DEBURR AND; BREAK SHARP; DO NOT SCALE DRAWING; REVISION; SCALE:1:2; SHEET 1 OF 1

other gears fixed
between bolt and
nyloc nut

Line sensor rod
mounted here

Hot glued to servo adapter

Trim adapter to
approximately 2cm
radius (avoid collision
between adapter and
bolts mounting the servo)

UNLESS OTHERWISE SPECIFIED:
DIMENSIONS ARE IN MILLIMETERS
SURFACE FINISH:
TOLERANCES:
LINEAR:
ANGULAR:

NAME | SIGNATURE | DATE | | | | TITLE:
DRAWN | Katie M

CHK'D
APPV'D
MFG
Q.A | | | | MATERIAL: | DWG NO. Door-assembly | A4

SOLIDWORKS Educational Product. For Instructional Use Only.
