LeoMaden/IDP-Robot-CAD/Documentation/pdf drawings/Robot-final-assembly.PDF

sensor location; Reflect ultrasound; Front doors; Rotary encoder toothed wheel; Battery box; Fruit storage; Arduino and motor shield; Door opening; Rear ball bearing caster; FINISH:; DEBURR AND; BREAK SHARP; DO NOT SCALE DRAWING; REVISION; SCALE:1:4; SHEET 1 OF 1

Team name and
LEDs plaque

Line and fruit sensor
assembly mount

UNLESS OTHERWISE SPECIFIED:
DIMENSIONS ARE IN MILLIMETERS
SURFACE FINISH:
TOLERANCES:
LINEAR:
ANGULAR:

NAME | SIGNATURE | DATE | | | | TITLE: Overview of the whole
L. Maden CHK'D | | | | | | robot assembly DRAWN

APPV'D
MFG
Q.A | | | | MATERIAL: Robot-final-assembly | DWG NO. | A3

SOLIDWORKS Educational Product. For Instructional Use Only.
