LeoMaden/IDP-Robot-CAD/Documentation/pdf drawings/Door-bracket.PDF

DOWN 90° R 0.5; FINISH:; DEBURR AND; BREAK SHARP; DO NOT SCALE DRAWING; REVISION; SCALE:1:1; SHEET 1 OF 1

UNLESS OTHERWISE SPECIFIED:
DIMENSIONS ARE IN MILLIMETERS
SURFACE FINISH:
TOLERANCES:
LINEAR:
ANGULAR:

NAME | SIGNATURE | DATE | | | | TITLE: Front Door Bracket Sheet Metal Drawing
DRAWN | L. Maden

CHK'D
APPV'D
MFG
Q.A | | | | MATERIAL: 0.7mm Mild steel sheet | DWG NO. Door-bracket | A3

SOLIDWORKS Educational Product. For Instructional Use Only.
