LeoMaden/IDP-Robot-CAD/Documentation/pdf drawings/Doors.PDF

Left door; DOWN 90° R 0.5; 0.7 mm Mild steel sheet; Spot weld; M3 Studding; Spot weld before bending; Right door; FINISH:; DEBURR AND; BREAK SHARP; DO NOT SCALE DRAWING; REVISION; SCALE:1:1; SHEET 1 OF 1

UNLESS OTHERWISE SPECIFIED:
DIMENSIONS ARE IN MILLIMETERS
SURFACE FINISH:
TOLERANCES:
LINEAR:
ANGULAR:
L. Maden

TITLE:
Left and right doors for the
fruit collection mechanism

APPV'D
MFG
Q.A | MATERIAL: 0.7 mm Mild steel plate M3 Studding | DWG NO. Doors | A3

SOLIDWORKS Educational Product. For Instructional Use Only.
