LeoMaden/IDP-Robot-CAD/(commit log)

2020-10-18 Add tunnel to model and holes for mounting motor
    [Large-motor.SLDPRT, Robot-assembly.SLDASM, Robot-body.sldprt]
2020-10-24 Add wheel & battery box to assembly, moved motor mounting holes forward slightly to give more space
    [Battery-box.SLDPRT, Robot-assembly.SLDASM, Robot-body.sldprt, Wheel.SLDPRT]
2020-10-24 Add servo and arduino to assembly
    [Arduino-motor-shield.SLDPRT, Battery-box.SLDPRT, Door-bracket.SLDPRT, Large-motor.SLDPRT, Robot-assembly.SLDASM, Robot-body.sldprt, Servo.SLDPRT, Wheel.SLDPRT]
2020-10-25 Add more parts and start on door assembly
    [Arduino-motor-shield.SLDPRT, Battery-box.SLDPRT, Door-assembly.SLDASM, Door-bracket.SLDPRT, Door-left.SLDPRT, Door-right.SLDPRT, Gears.SLDPRT, Large-motor.SLDPRT]
2020-10-25 Add door bracket and door assembly to main assembly
    [Arduino-motor-shield.SLDPRT, Battery-box.SLDPRT, Door-assembly.SLDASM, Door-bracket.SLDPRT, Door-left.SLDPRT, Door-right.SLDPRT, Gears.SLDPRT, Large-motor.SLDPRT]
2020-10-25 Make start on door mechanism
    [Door-assembly.SLDASM, Gears.SLDPRT, Robot-assembly.SLDASM]
2020-10-25 Save assembly
    [Robot-assembly.SLDASM]
2020-10-26 made caster ball part
    [Caster Ball.SLDPRT]
2020-10-26 Added new gears to door mechanism
    [Door-assembly.SLDASM, Door-bracket.SLDPRT, Gears 40mm.SLDPRT, Gears.SLDPRT]
2020-10-26 Tidy up files & gears
    [Door-assembly.SLDASM, Gears 40mm.SLDPRT, Gears.SLDPRT, Robot-assembly.SLDASM, Robot-body.sldprt]
2020-10-26 Update servo dimensions
    [Door-bracket.SLDPRT, Servo.SLDPRT]
2020-10-26 Add bolts to mount servo to door bracket and mated door bracket in robot assembly
    [Door-assembly.SLDASM, Door-bracket.SLDPRT, Robot-assembly.SLDASM, Robot-body.sldprt, Servo.SLDPRT]
2020-10-26 Make robot body smaller and fix door sizes
    [Door-left.SLDPRT, Door-right.SLDPRT, Robot-assembly.SLDASM, Robot-body.sldprt]
2020-10-26 Add servo piece to mount gear to - gears need rearranging so they fit
    [Door-assembly.SLDASM, Servo-spline-piece.SLDPRT, Servo.SLDPRT]
2020-10-27 Finish door mechanism
    [Door-assembly.SLDASM, Door-bracket.SLDPRT, Servo.SLDPRT]
2020-10-27 Add drawing for door bracket
    [Door-assembly.SLDASM, Door-bracket.SLDDRW, Door-bracket.SLDPRT]
2020-10-27 Save robot
    [Door-assembly.SLDASM, Door-bracket.SLDPRT, Robot-assembly.SLDASM, Robot-body.sldprt]
2020-10-27 Add toothed wheel for rotary encoder
    [Toothed-wheel.SLDPRT]
2020-10-27 Check robot ride height
    [Door-assembly.SLDASM, Robot-assembly.SLDASM, Robot-body.sldprt]
2020-10-27 Make laser cutter pieces for robot body
    [Body-bottom.DXF, Body-front.DXF, Body-left.DXF, Body-rear.DXF, Body-right.DXF, Door-assembly.SLDASM, Door-bracket.SLDPRT, Name-plaque.DXF]
2020-10-27 Started on tunnel laser cutter pieces
    [Robot-body.sldprt]
2020-10-27 Added Tunnel Laser Cutter Files
    [Tunnel-back.DXF, Tunnel-left.DXF, Tunnel-right.DXF, Tunnel-top.DXF]
2020-11-01 Add cut out so doors can open fully, modified toothed wheel to fit on main wheel
    [Door-assembly.SLDASM, Robot-assembly.SLDASM, Robot-body.sldprt, Toothed-wheel.SLDPRT, Wheel.SLDPRT]
2020-11-02 Create laser cutter drawing for toother wheel
    [Toothed-wheel.DXF]
2020-11-03 Update robot design with door cutout and ultrasound sensor pieces, including laser cutter drawings
    [Arduino-motor-shield.SLDPRT, Battery-box.SLDPRT, Caster Ball.SLDPRT, Door-assembly.SLDASM, Door-bracket.SLDPRT, Door-left.SLDPRT, Door-right.SLDPRT, Gears.SLDPRT]
2020-11-08 Finish door bracket drawing and create documentation folder
    [Door-bracket.SLDDRW, Door-bracket.SLDPRT, Robot-assembly.SLDASM]
2020-11-08 Create drawing for toothed wheel
    [Arduino-motor-shield.SLDPRT, Battery-box.SLDPRT, Caster Ball.SLDPRT, Door-assembly.SLDASM, Door-bracket.SLDDRW, Door-bracket.SLDPRT, Door-left.SLDPRT, Door-right.SLDPRT]
2020-11-08 Create drawing for the doors
    [Arduino-motor-shield.SLDPRT, Battery-box.SLDPRT, Caster Ball.SLDPRT, Door-assembly.SLDASM, Door-bracket.SLDPRT, Door-left.SLDPRT, Door-right - Copy.SLDPRT, Door-right.SLDPRT]
2020-11-08 added laser cutter tunnel pieces
    [Robot-body.sldprt]
2020-11-08 Create body front piece part and drawing
    [Body-front.SLDDRW, Body-front.sldprt, Robot-body.sldprt]
2020-11-08 Created drawing and parts for body side pieces
    [Body-left.sldprt, Body-right.sldprt, Body-sides.SLDDRW, Robot-body.sldprt]
2020-11-08 Create new assembly from laser cut pieces and overall drawing of the final robot
    [Arduino-motor-shield.SLDPRT, Battery-box.SLDPRT, Body-bottom.sldprt, Body-front.sldprt, Body-left.sldprt, Body-rear.sldprt, Body-right.sldprt, Caster Ball.SLDPRT]
2020-11-08 Create pdfs from drawings and organised doeumentation
    [Body-bottom.DXF, Body-front.DXF, Body-left.DXF, Body-rear.DXF, Body-right.DXF, Door-assembly.SLDASM, Door-bracket.SLDDRW, Door-bracket.SLDPRT]
2020-11-09 Drawing of Door Assembly added
    [Door-assembly.SLDASM, Door-assembly.SLDDRW]
2020-11-09 Finish documentation
    [Body-bottom.DXF, Body-front.DXF, Body-left.DXF, Body-rear.DXF, Body-right.DXF, Name-plaque.DXF, New-Body-bottom.DXF, New-Body-front.DXF]
